RWTH-ACS/dino/sw/arduino/analog-in/README.md

# ADC LTC1864 - 16bit

## Components
  - [LTC2312-14 Datasheet](https://www.analog.com/media/en/technical-documentation/data-sheets/231214fa.pdf)

## Code

In ```ltc_test``` you find the code used to test the SPI communication using the following wiring setup

## Test Wiring

Wiring

**NOTE: The chip in picture is the LTC2312-14**
