RWTH-ACS/dino/hw/eagle/fpga-fmc/adapter_board.csv

Part | Value | Device | Package | Description | Added
3V3_GOOD2 |  | LEDCHIPLED_0805 | CHIPLED_0805 | LED | y
5V_GOOD |  | LEDCHIPLED_0805 | CHIPLED_0805 | LED | y
12V_GOOD |  | LEDCHIPLED_0805 | CHIPLED_0805 | LED | y
C1 | 100n | C-EUC0805 | C0805 | CAPACITOR, European symbol | y
C2 | 100n | C-EUC0805 | C0805 | CAPACITOR, European symbol | y
C3 | 100n | C-EUC0805 | C0805 | CAPACITOR, European symbol | y
C4 | 1u | C-EUC0805 | C0805 | CAPACITOR, European symbol | y
C5 | 100n | C-EUC0805 | C0805 | CAPACITOR, European symbol | y
C6 | 100n | C-EUC0805 | C0805 | CAPACITOR, European symbol | y
C7 | 100n | C-EUC0805 | C0805 | CAPACITOR, European symbol | y
C8 | 100n | C-EUC0805 | C0805 | CAPACITOR, European symbol | y
C9 | 100n | C-EUC0805 | C0805 | CAPACITOR, European symbol | y
C10 | 100n | C-EUC0805 | C0805 | CAPACITOR, European symbol | y
C11 | 100n | C-EUC0805 | C0805 | CAPACITOR, European symbol | y
C12 | 100n | C-EUC0805 | C0805 | CAPACITOR, European symbol | y
C13 | 100n | C-EUC0805 | C0805 | CAPACITOR, European symbol | y
C14 | 100n | C-EUC0805 | C0805 | CAPACITOR, European symbol | y
C15 | 100n | C-EUC0805 | C0805 | CAPACITOR, European symbol | y
C16 | 100n | C-EUC0805 | C0805 | CAPACITOR, European symbol | y
C17 | 100n | C-EUC0805 | C0805 | CAPACITOR, European symbol | y
C18 | 100n | C-EUC0805 | C0805 | CAPACITOR, European symbol | y
C19 | 100n | C-EUC0805 | C0805 | CAPACITOR, European symbol | y
C20 | 100n | C-EUC0805 | C0805 | CAPACITOR, European symbol | y
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
RJ3_SCL | TPB1,27 | TPB1,27 | B1,27 | Test pad | nb
RJ3_SDO | TPB1,27 | TPB1,27 | B1,27 | Test pad | nb
U18 | TXS0102 | TXS0102 | VSSOP-8 |  | y
U19 | TXS0102 | TXS0102 | VSSOP-8 |  | y
U20 | TXS0102 | TXS0102 | VSSOP-8 |  | y
U21 | TXS0102 | TXS0102 | VSSOP-8 |  | y
U1 | ADM3066E | ADM3066E | MSOP-10 |  | y
U2 | ADM3066E | ADM3066E | MSOP-10 |  | y
U3 | ADM3066E | ADM3066E | MSOP-10 |  | y
U4 | ADM3066E | ADM3066E | MSOP-10 |  | y
U5 | ADM3066E | ADM3066E | MSOP-10 |  | y
U6 | ADM3066E | ADM3066E | MSOP-10 |  | y
U7 | ADM3066E | ADM3066E | MSOP-10 |  | y
U8 | ADM3066E | ADM3066E | MSOP-10 |  | y
U9 | ADM3066E | ADM3066E | MSOP-10 |  | y
U10 | ADM3066E | ADM3066E | MSOP-10 |  | y
U11 | ADM3066E | ADM3066E | MSOP-10 |  | y
U12 | ADM3066E | ADM3066E | MSOP-10 |  | y
U13 | ADM3066E | ADM3066E | MSOP-10 |  | y
U14 | ADM3066E | ADM3066E | MSOP-10 |  | y
U15 | ADM3066E | ADM3066E | MSOP-10 |  | y
U16 | ADM3066E | ADM3066E | MSOP-10 |  | y
U17 | TCA9548A | PCA9548A | PCA9548 |  | self
X1 |  | W237-02P | W237-132 | WAGO SREW CLAMP | y
