RWTH-ACS/dino/hw/eagle/analog-in/diagram.pdf

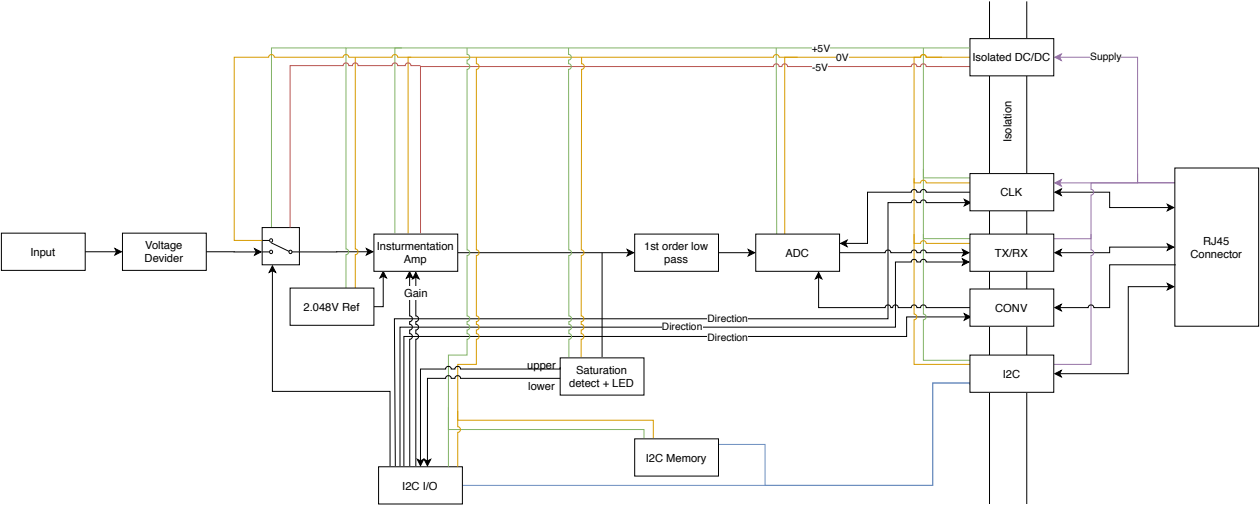
[picture p1: page 1]
Direction; Voltage; Devider Input; 1st order low; pass; ADC; CLK; Supply; RJ45 Connector; Isolated DC/DC; 2.048V Ref; I2C Memory; Isolation; CONV; Insturmentation Amp; Saturation detect + LED; upper; lower; Gain
