RWTH-ACS/dino/hw/kicad/analog-in/analog-in.kicad_pcb

## KiCad design hw/kicad/analog-in/analog-in.kicad_pcb (2024-04-16)

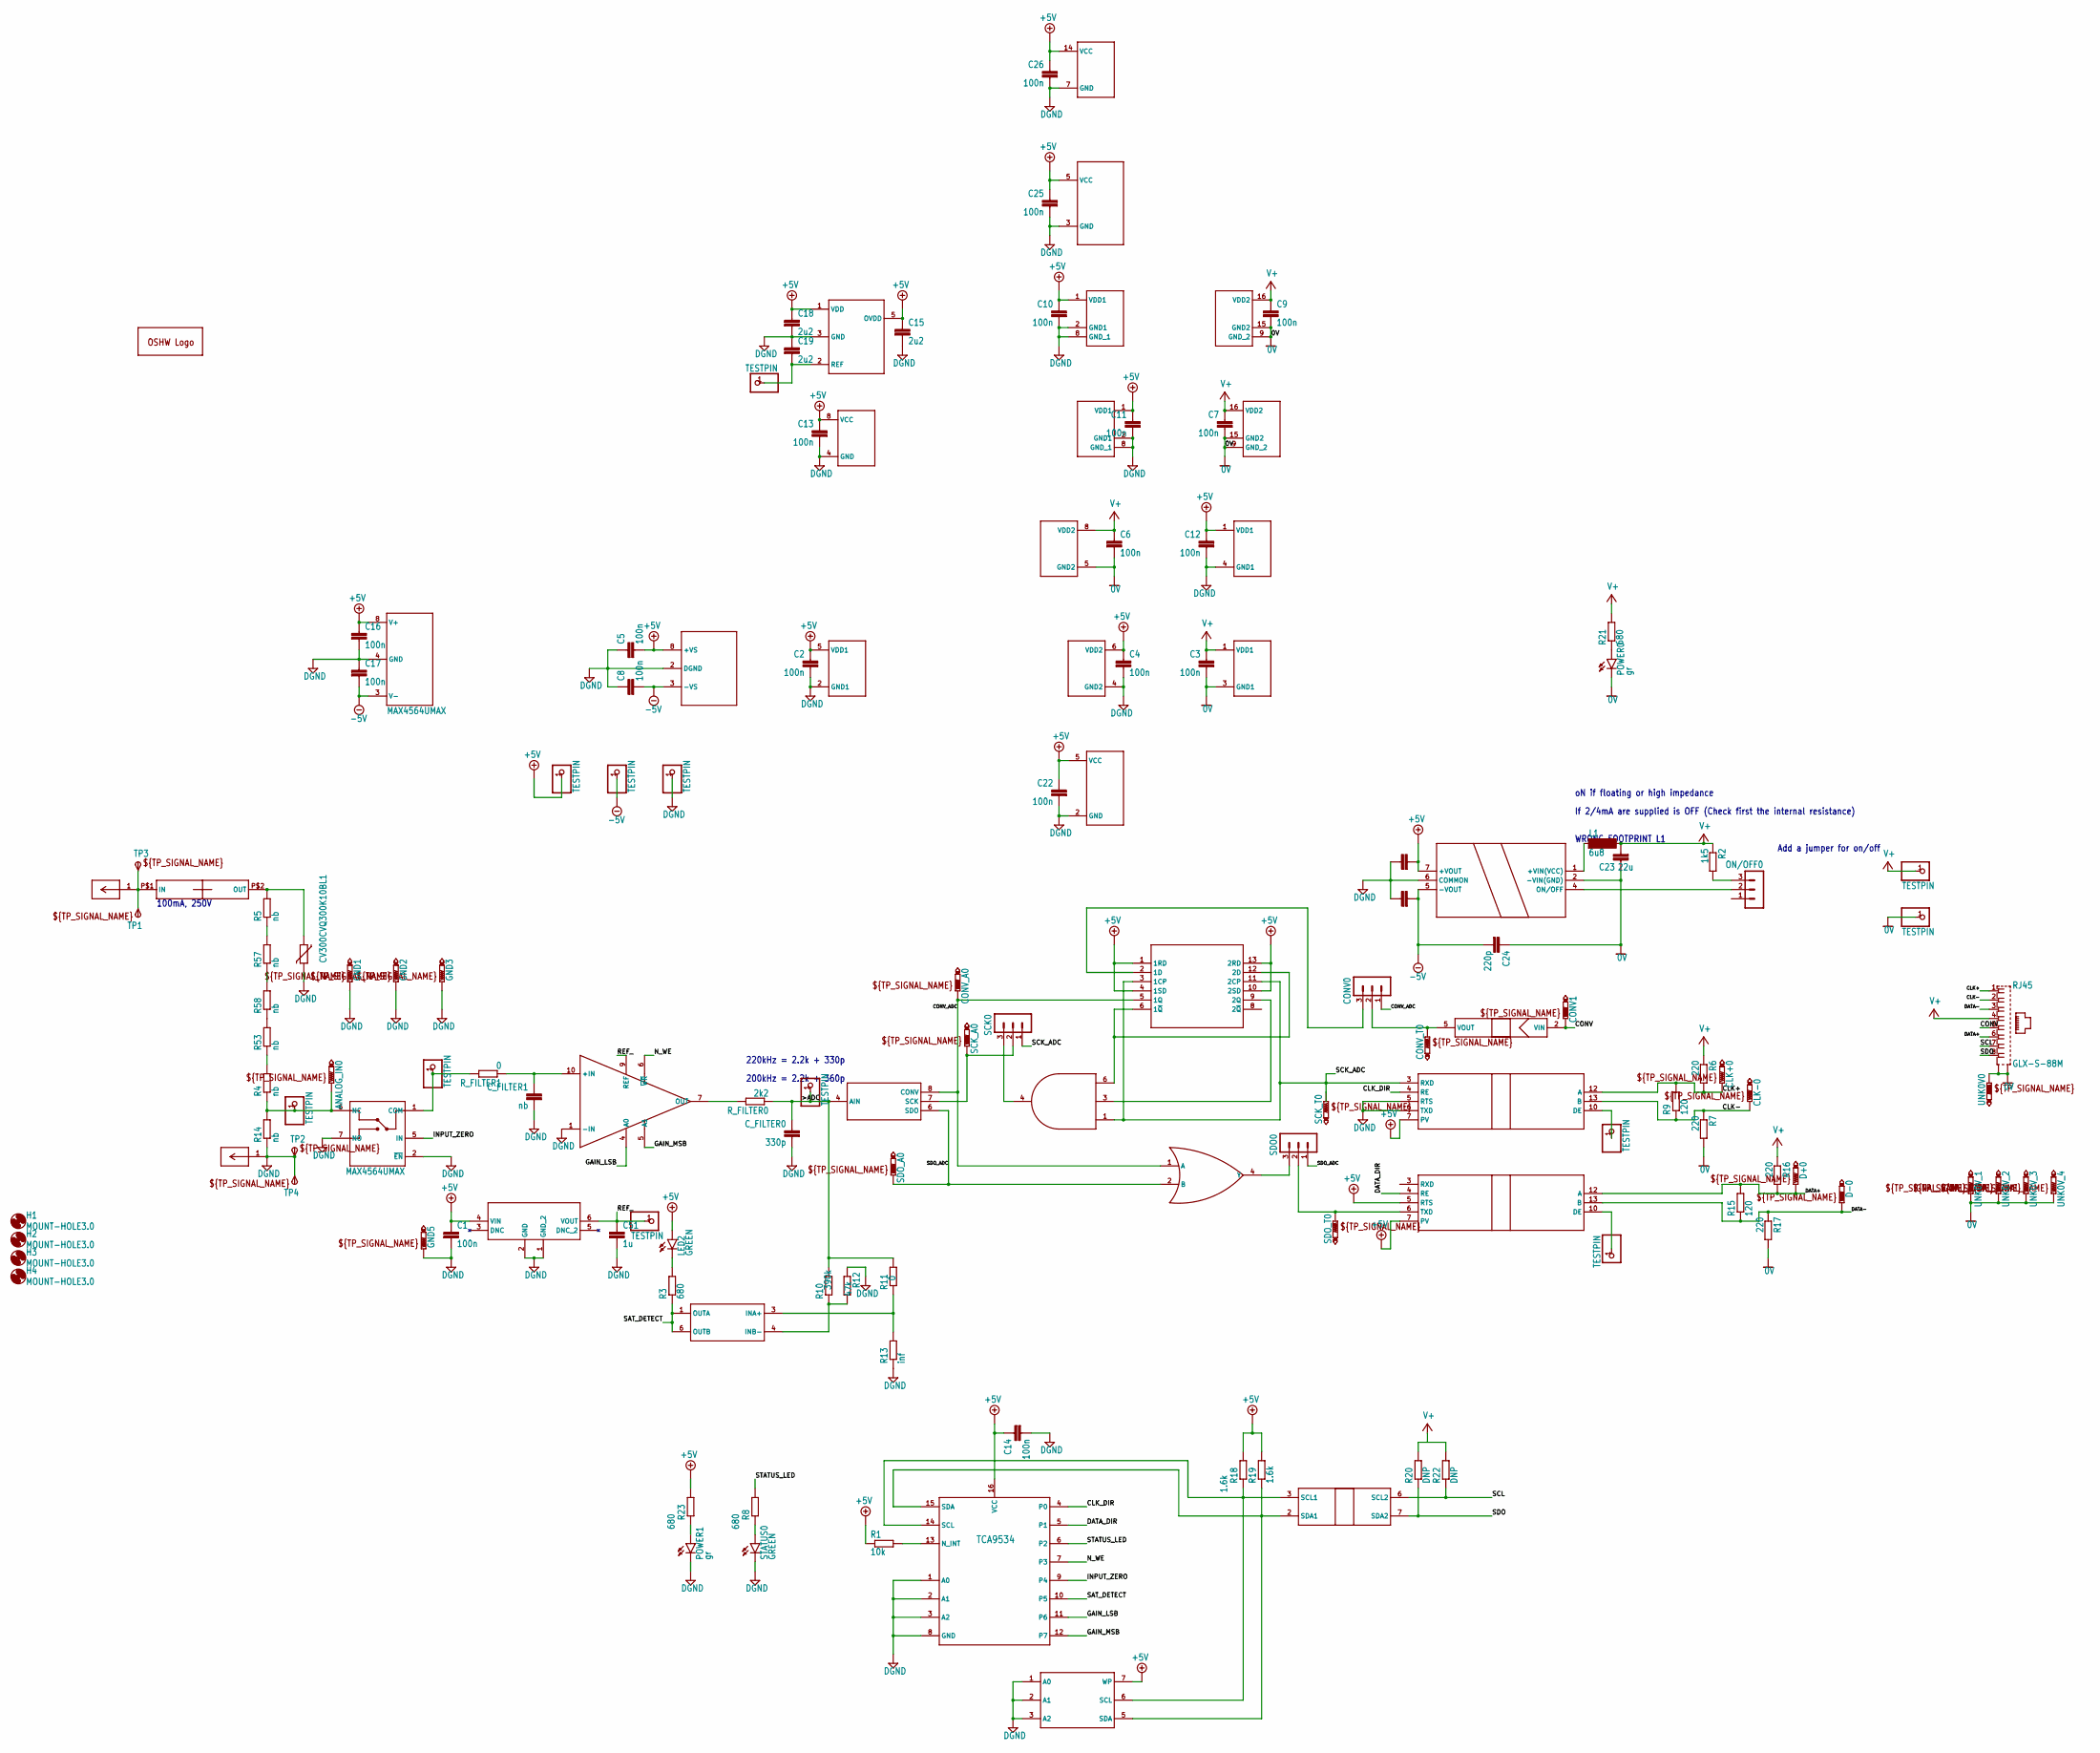
[picture p2: schematic analog-in.kicad_sch]

Parts:
+5V0: TESTPIN; 1X01
-5V0: TESTPIN; 1X01
ADC_0: LTC2314-14; TSOT-23_TS8_LIT; DIGIKEY LTC2314ITS8-14#TRMPBFT-ND
ADC_IN0: TESTPIN; 1X01
ADC_REF0: TESTPIN; 1X01
ANALOG_IN0: PTR1B1,27; B1,27
A_IN0: TESTPIN; 1X01
C1: 100n; C0805; DIGIKEY 478-7962-1-ND
C2, C3, C4, C5, C6, C7, C8, C9, C10, C11, C12, C13, C14, C16, C17, C20, C21, C22, C25, C26: 100n; C0805K; DIGIKEY 478-7962-1-ND
C15, C18, C19: 2u2; C0805K; DIGIKEY 1276-2954-2-ND
C23: 22u; C1206; DIGIKEY 399-17625-1-ND
C24: 220p; C1808; DIGIKEY 478-10448-2-ND
C51: 1u; C0805; DIGIKEY 1276-6471-1-ND
CLK+0: PTR1B1,27; B1,27
CLK-0: PTR1B1,27; B1,27
CONV0: MA03-1; DIGIKEY 732-5316-ND
CONV1: PTR1B1,27; B1,27
CONVERSION0: ADUM4120-1ARIZ; RI_6_1_ADI; DIGIKEY ADUM4120-1ARIZ-ND
CONV_A0: PTR1B1,27; B1,27
CONV_T0: PTR1B1,27; B1,27
C_FILTER0: 330p; C0805K; DIGIKEY 478-9885-1-ND
C_FILTER1: nb; C0805K; DIGIKEY 478-08055C121KAT2ACT-ND
D+0: PTR1B1,27; B1,27
D-0: PTR1B1,27; B1,27
DC-DC_CONVERTER0: TDN_3-1211WI; TDN3_TRP; MANUFACTURER_PART_NUMBER TDN 3-1221WISM; DIGIKEY TDN3-1221WISM-ND
DE_CLK0: TESTPIN; 1X01
DE_DATA0: TESTPIN; 1X01
DGND0: TESTPIN; 1X01
FILTER0: TESTPIN; 1X01
FLIP-FLOP0: 74HC74PW-Q100,118; TSSOP14_SOT402-1_NEX; DIGIKEY 1727-4083-1-ND
GND1, GND2, GND3, GND5: PTR1B1,27; B1,27
GND_4: TESTPIN; 1X01
GOLD_ORB_SM1: OSHWLOGOLOGO8MM; OSHW_8MM
H1, H2, H3, H4: MOUNT-HOLE3.0; 3,0
I2C0: ADUM1251WARZ; R_8_ADI; DIGIKEY ADUM1251ARZ-RL7TR-ND
INSTR_AMP0: AD8250ARMZ; RM_10_ADI; DIGIKEY AD8250ARMZ-R7TR-ND
L1: 6u8; SM-NE29; DIGIKEY 1951-1045-ND
LED2: GREEN; SML0805; DIGIKEY LTST-C170GKT
MINUS0: 23.3200-21; CONN_23.3200-21_SBI; DIGIKEY 501-73099-0-ND
MOV1: CV300CVQ300K10BL1; CVQ300K10
ON/OFF0: MA03-1; DIGIKEY 732-5316-ND
PLUS0: 23.3200-21; CONN_23.3200-21_SBI; DIGIKEY 501-73099-2-ND
POWER0, POWER1: gr; SML0805; DIGIKEY LTST-C170GKT
R1: 10k; R0805; DIGIKEY P10KDATR-ND
R2: 1k5; R0805; DIGIKEY P1.5KDATR-ND
R3, R21: 680; R0805; DIGIKEY A129747TR-ND
R4, R5, R53, R57, R58: nb; R1206; MOUSER check config
R6, R7, R16, R17: 220; R0805; DIGIKEY Y1624195R000Q9R-ND
R8, R23: 680; R0805
R9, R15: 120; R0805; DIGIKEY Y1629-120DTR-ND
R10: 390k; R0805; DIGIKEY 2019-RK73H2ATTD3903FTR-ND
R11: 0; R0805; DIGIKEY RMCF0805ZT0R00TR-ND
R12: 47k; R0805; DIGIKEY A130144TR-ND
R13: inf; R0805
R14: nb; R0805; MOUSER check config
R18, R19: 1.6k; R0805
R20, R22: DNP; R0805
REF0: LT6654AIS6-2.048TRMPBF; S_6_ADI; DIGIKEY 161-LT6654BHS6-2.048#WTRPBFTR-ND
REF_2.048: TESTPIN; 1X01
RJ45: GLX-S-88M; DIGIKEY 2092-GLX-S-88M-ND
ROHM_I2C0: BR24T1MF-3AM; BR24T1MFJ-3AM; DIGIKEY BR24T1MF-3AME2TR-ND
R_FILTER0: 2k2; R0805; DIGIKEY A106060TR-ND
R_FILTER1: 0; R0805; DIGIKEY P220DACT-ND
SATURATION_DETECT0: ADCMP670-1YUJZ-RL7; UJ_6_ADI; DIGIKEY ADCMP670-1YUJZ-RL7TR-ND
SCK0: MA03-1; DIGIKEY 732-5316-ND
SCK_A0: PTR1B1,27; B1,27
SCK_T0: PTR1B1,27; B1,27
SDO0: MA03-1; DIGIKEY 732-5316-ND
SDO_A0: PTR1B1,27; B1,27
SDO_T0: PTR1B1,27; B1,27
SERIAL_CLOCK0: ADM2486BRWZ-REEL; RW_16_ADI; DIGIKEY ADM2486BRWZ-REELTR-ND
SERIAL_DATA0: ADM2486BRWZ-REEL; RW_16_ADI; DIGIKEY ADM2486BRWZ-REELTR-ND
SN74LVC1G32: SN74LVC1G32DCKTDCK5-M; DCK5-M
STATUS0: GREEN; CHIPLED_0805; DIGIKEY LTST-C170GKT
TP1, TP2, TP3, TP4: TPSTP20SQ; TP20SQ
U$1: 0508.500MXEP; DIGIKEY 283-4458-1-ND
U$2: TCA9534; TSSOP16L
U$20: MAX4564UMAX; UMAX8; DIGIKEY MAX4564EUA+TR-ND
UNK0V0, UNK0V_1, UNK0V_2, UNK0V_3, UNK0V_4: PTR1B1,27; B1,27
UNK74LVC1G11: SN74LVC1G11DBVRDBV0006A_L; DBV0006A_L
VCC0: TESTPIN; 1X01

Connections:
0V: C3.2, C6.2, C7.2, C9.2, C23.1, C24.1, CONVERSION0.3 (GND1), DC-DC_CONVERTER0.2 (-VIN(GND)), DGND0.1, I2C0.5 (GND2), POWER0.C, R7.2, R17.2, RJ45.S1, RJ45.S2, SERIAL_CLOCK0.9 (GND_2), SERIAL_CLOCK0.15 (GND2), SERIAL_DATA0.9 (GND_2), SERIAL_DATA0.15 (GND2), UNK0V0.TP, UNK0V_1.TP, UNK0V_2.TP, UNK0V_3.TP, UNK0V_4.TP
+5V: +5V0.1, ADC_0.1 (VDD), ADC_0.5 (OVDD), C1.1, C2.1, C4.1, C5.2, C10.1, C11.1, C12.1, C13.1, C14.1, C15.1, C16.1, C18.1, C20.2, C22.1, C25.1, C26.1, CONVERSION0.6 (VDD2), DC-DC_CONVERTER0.7 (+VOUT), FLIP-FLOP0.1 (1RD), FLIP-FLOP0.4 (1SD), FLIP-FLOP0.10 (2SD), FLIP-FLOP0.13 (2RD), FLIP-FLOP0.14 (VCC), I2C0.1 (VDD1), INSTR_AMP0.8 (+VS), LED2.A, R1.1, R18.2, R19.2, R23.2, REF0.4 (VIN), ROHM_I2C0.7 (WP), ROHM_I2C0.8 (VCC), SATURATION_DETECT0.5 (VDD1), SERIAL_CLOCK0.1 (VDD1), SERIAL_CLOCK0.7 (PV), SERIAL_DATA0.1 (VDD1), SERIAL_DATA0.5 (RTS), SERIAL_DATA0.7 (PV), SN74LVC1G32.5 (VCC), U$2.16 (VCC), U$20.8 (V+), UNK74LVC1G11.5 (VCC)
-5V: -5V0.1, C8.2, C17.2, C21.2, C24.2, DC-DC_CONVERTER0.5 (-VOUT), INSTR_AMP0.3 (-VS), U$20.3 (V-)
>ADC: ADC_0.4 (AIN), ADC_IN0.1, C_FILTER0.1, R10.2, R11.2, R_FILTER0.1
CLK+: CLK+0.TP, R6.2, R9.2, RJ45.1, SERIAL_CLOCK0.12 (A)
CLK-: CLK-0.TP, R7.1, R9.1, RJ45.2, SERIAL_CLOCK0.13 (B)
CLK_DIR: SERIAL_CLOCK0.4 (RE), U$2.4 (P0)
CONV: CONV1.TP, CONVERSION0.2 (VIN), RJ45.5
CONV_ADC: ADC_0.8 (CONV), CONV0.1, CONV_A0.TP, FLIP-FLOP0.5 (1Q), SN74LVC1G32.1 (A)
DATA+: D+0.TP, R15.2, R16.2, RJ45.6, SERIAL_DATA0.12 (A)
DATA-: D-0.TP, R15.1, R17.1, RJ45.3, SERIAL_DATA0.13 (B)
DATA_DIR: SERIAL_DATA0.4 (RE), U$2.5 (P1)
DGND: ADC_0.3 (GND), C1.2, C2.2, C4.2, C5.1, C8.1, C10.2, C11.2, C12.2, C13.2, C14.2, C15.2, C16.2, C17.1, C18.2, C19.1, C20.1, C21.1, C22.2, C25.2, C26.2, C51.2, CONVERSION0.4 (GND2), C_FILTER0.2, C_FILTER1.2, DC-DC_CONVERTER0.6 (COMMON), FLIP-FLOP0.7 (GND), GND1.TP, GND2.TP, GND3.TP, GND5.TP, GND_4.1, I2C0.4 (GND1), INSTR_AMP0.1 (-IN), INSTR_AMP0.2 (DGND), MINUS0.1, MOV1.2, POWER1.C, R12.1, R13.1, R14.1, REF0.1 (GND_2), REF0.2 (GND), ROHM_I2C0.1 (A0), ROHM_I2C0.2 (A1), ROHM_I2C0.3 (A2), ROHM_I2C0.4 (GND), SATURATION_DETECT0.2 (GND1), SERIAL_CLOCK0.2 (GND1), SERIAL_CLOCK0.5 (RTS), SERIAL_CLOCK0.6 (TXD), SERIAL_CLOCK0.8 (GND_1), SERIAL_DATA0.2 (GND1), SERIAL_DATA0.8 (GND_1), SN74LVC1G32.3 (GND), STATUS0.C, TP2.TP, TP4.TP, U$2.1 (A0), U$2.2 (A1), U$2.3 (A2), U$2.8 (GND), U$20.2 (~EN), U$20.4 (GND), U$20.7 (NO), UNK74LVC1G11.2 (GND)
GAIN_LSB: INSTR_AMP0.4 (A0), U$2.11 (P6)
GAIN_MSB: INSTR_AMP0.5 (A1), U$2.12 (P7)
INPUT_ZERO: U$2.9 (P4), U$20.5 (IN)
unnamed: INSTR_AMP0.7 (OUT), R_FILTER0.2
unnamed: R1.2, U$2.13 (N_INT)
unnamed: DE_CLK0.1, SERIAL_CLOCK0.10 (DE)
unnamed: I2C0.3 (SCL1), R18.1, ROHM_I2C0.6 (SCL), U$2.14 (SCL)
unnamed: FILTER0.1, R_FILTER1.2, U$20.1 (COM)
unnamed: I2C0.2 (SDA1), R19.1, ROHM_I2C0.5 (SDA), U$2.15 (SDA)
unnamed: DE_DATA0.1, SERIAL_DATA0.10 (DE)
unnamed: ADC_0.2 (REF), ADC_REF0.1, C19.2
unnamed: MOV1.1, R5.2, U$1.P$2 (OUT)
unnamed: DC-DC_CONVERTER0.1 (+VIN(VCC)), L1.1
unnamed: ON/OFF0.3, R2.2
unnamed: DC-DC_CONVERTER0.4 (ON/OFF), ON/OFF0.2
unnamed: SCK0.3, UNK74LVC1G11.4 (Y)
unnamed: LED2.C, R3.2
unnamed: C_FILTER1.1, INSTR_AMP0.10 (+IN), R_FILTER1.1
unnamed: PLUS0.1, TP1.TP, TP3.TP, U$1.P$1 (IN)
unnamed: R10.1, R12.2, SATURATION_DETECT0.4 (INB-)
unnamed: R11.1, R13.2, SATURATION_DETECT0.3 (INA+)
unnamed: FLIP-FLOP0.6 (1~Q), FLIP-FLOP0.12 (2D), UNK74LVC1G11.6 (C)
unnamed: ANALOG_IN0.TP, A_IN0.1, R4.1, R14.2, U$20.6 (NC)
unnamed: R57.1, R58.2
unnamed: R8.1, STATUS0.A
unnamed: FLIP-FLOP0.9 (2Q), UNK74LVC1G11.3 (B)
unnamed: CONV0.2, CONVERSION0.5 (VOUT), CONV_T0.TP
unnamed: CONV0.3, FLIP-FLOP0.2 (1D)
unnamed: ADC_0.7 (SCK), SCK0.2, SCK_A0.TP
unnamed: POWER1.A, R23.1
unnamed: R4.2, R53.1
unnamed: SDO0.2, SDO_T0.TP, SERIAL_DATA0.6 (TXD)
unnamed: SDO0.3, SN74LVC1G32.4 (Y)
unnamed: POWER0.A, R21.1
unnamed: R53.2, R58.1
unnamed: R5.1, R57.2
N_WE: INSTR_AMP0.6 (~WR), U$2.7 (P3)
REF_: C51.1, INSTR_AMP0.9 (REF), REF0.6 (VOUT), REF_2.048.1
SAT_DETECT: R3.1, SATURATION_DETECT0.1 (OUTA), SATURATION_DETECT0.6 (OUTB), U$2.10 (P5)
SCK_ADC: FLIP-FLOP0.3 (1CP), FLIP-FLOP0.11 (2CP), SCK0.1, SCK_T0.TP, SERIAL_CLOCK0.3 (RXD), UNK74LVC1G11.1 (A)
SCL: I2C0.6 (SCL2), R22.1, RJ45.7
SDO: I2C0.7 (SDA2), R20.1, RJ45.8
SDO_ADC: ADC_0.6 (SDO), SDO0.1, SDO_A0.TP, SN74LVC1G32.2 (B)
STATUS_LED: R8.2, U$2.6 (P2)
V+: C3.1, C6.1, C7.1, C9.1, C23.2, CONVERSION0.1 (VDD1), I2C0.8 (VDD2), L1.2, R2.1, R6.1, R16.1, R20.2, R21.2, R22.2, RJ45.4, SERIAL_CLOCK0.16 (VDD2), SERIAL_DATA0.16 (VDD2), VCC0.1

Notes on the sheet:
220kHz = 2.2k + 330p
WRONG FOOTPRINT L1
If 2/4mA are supplied is OFF (Check first the internal resistance)
Add a jumper for on/off
100mA, 250V
oN if floating or high impedance
200kHz = 2.2k + 360p

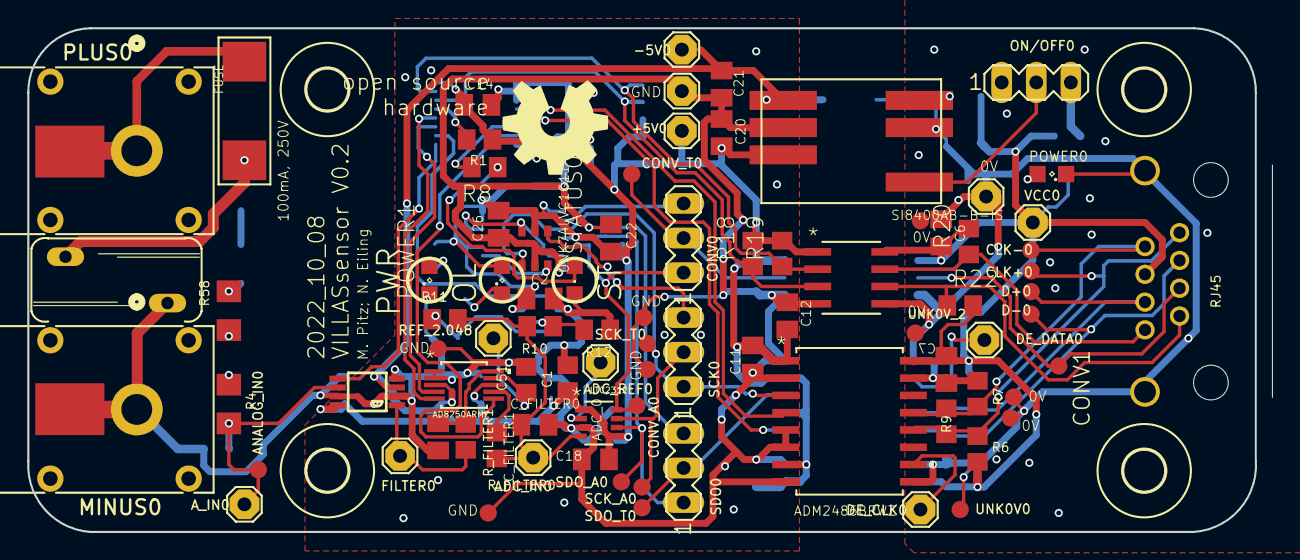
[picture p3: board analog-in.kicad_pcb from above]

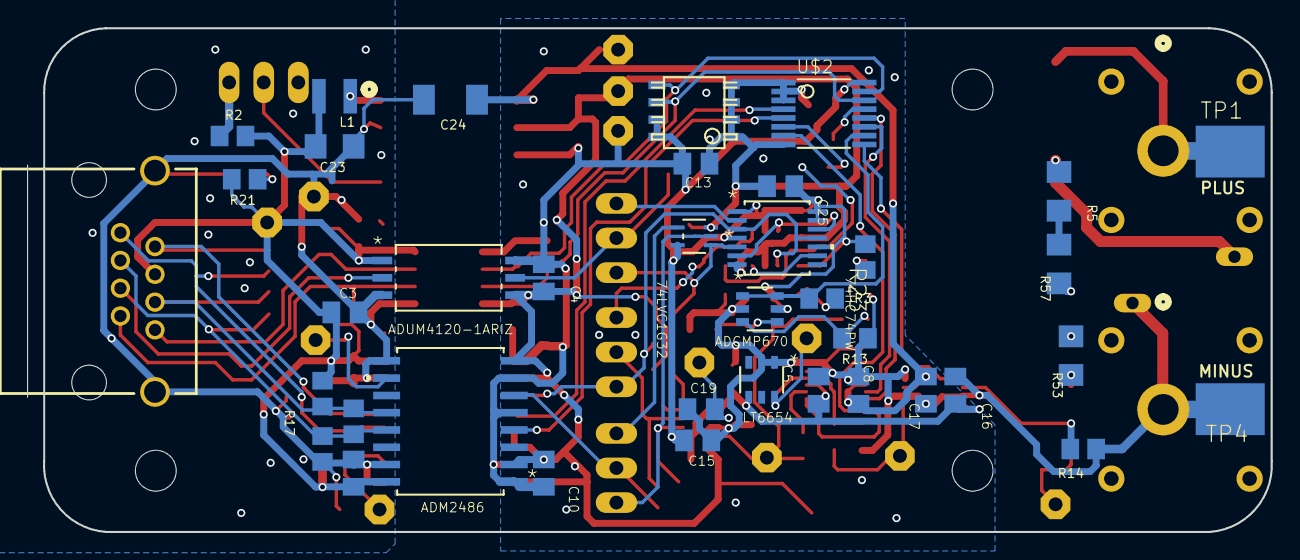
[picture p4: board analog-in.kicad_pcb from below]

Board: 2 copper layers, 91.4 x 37.0 mm, 128 parts (37 on the bottom side), 58 nets.
