RWTH-ACS/dino/hw/eagle/analog-out/analog-out.brd

## EAGLE design hw/eagle/analog-out/analog-out.brd (2023-10-16)

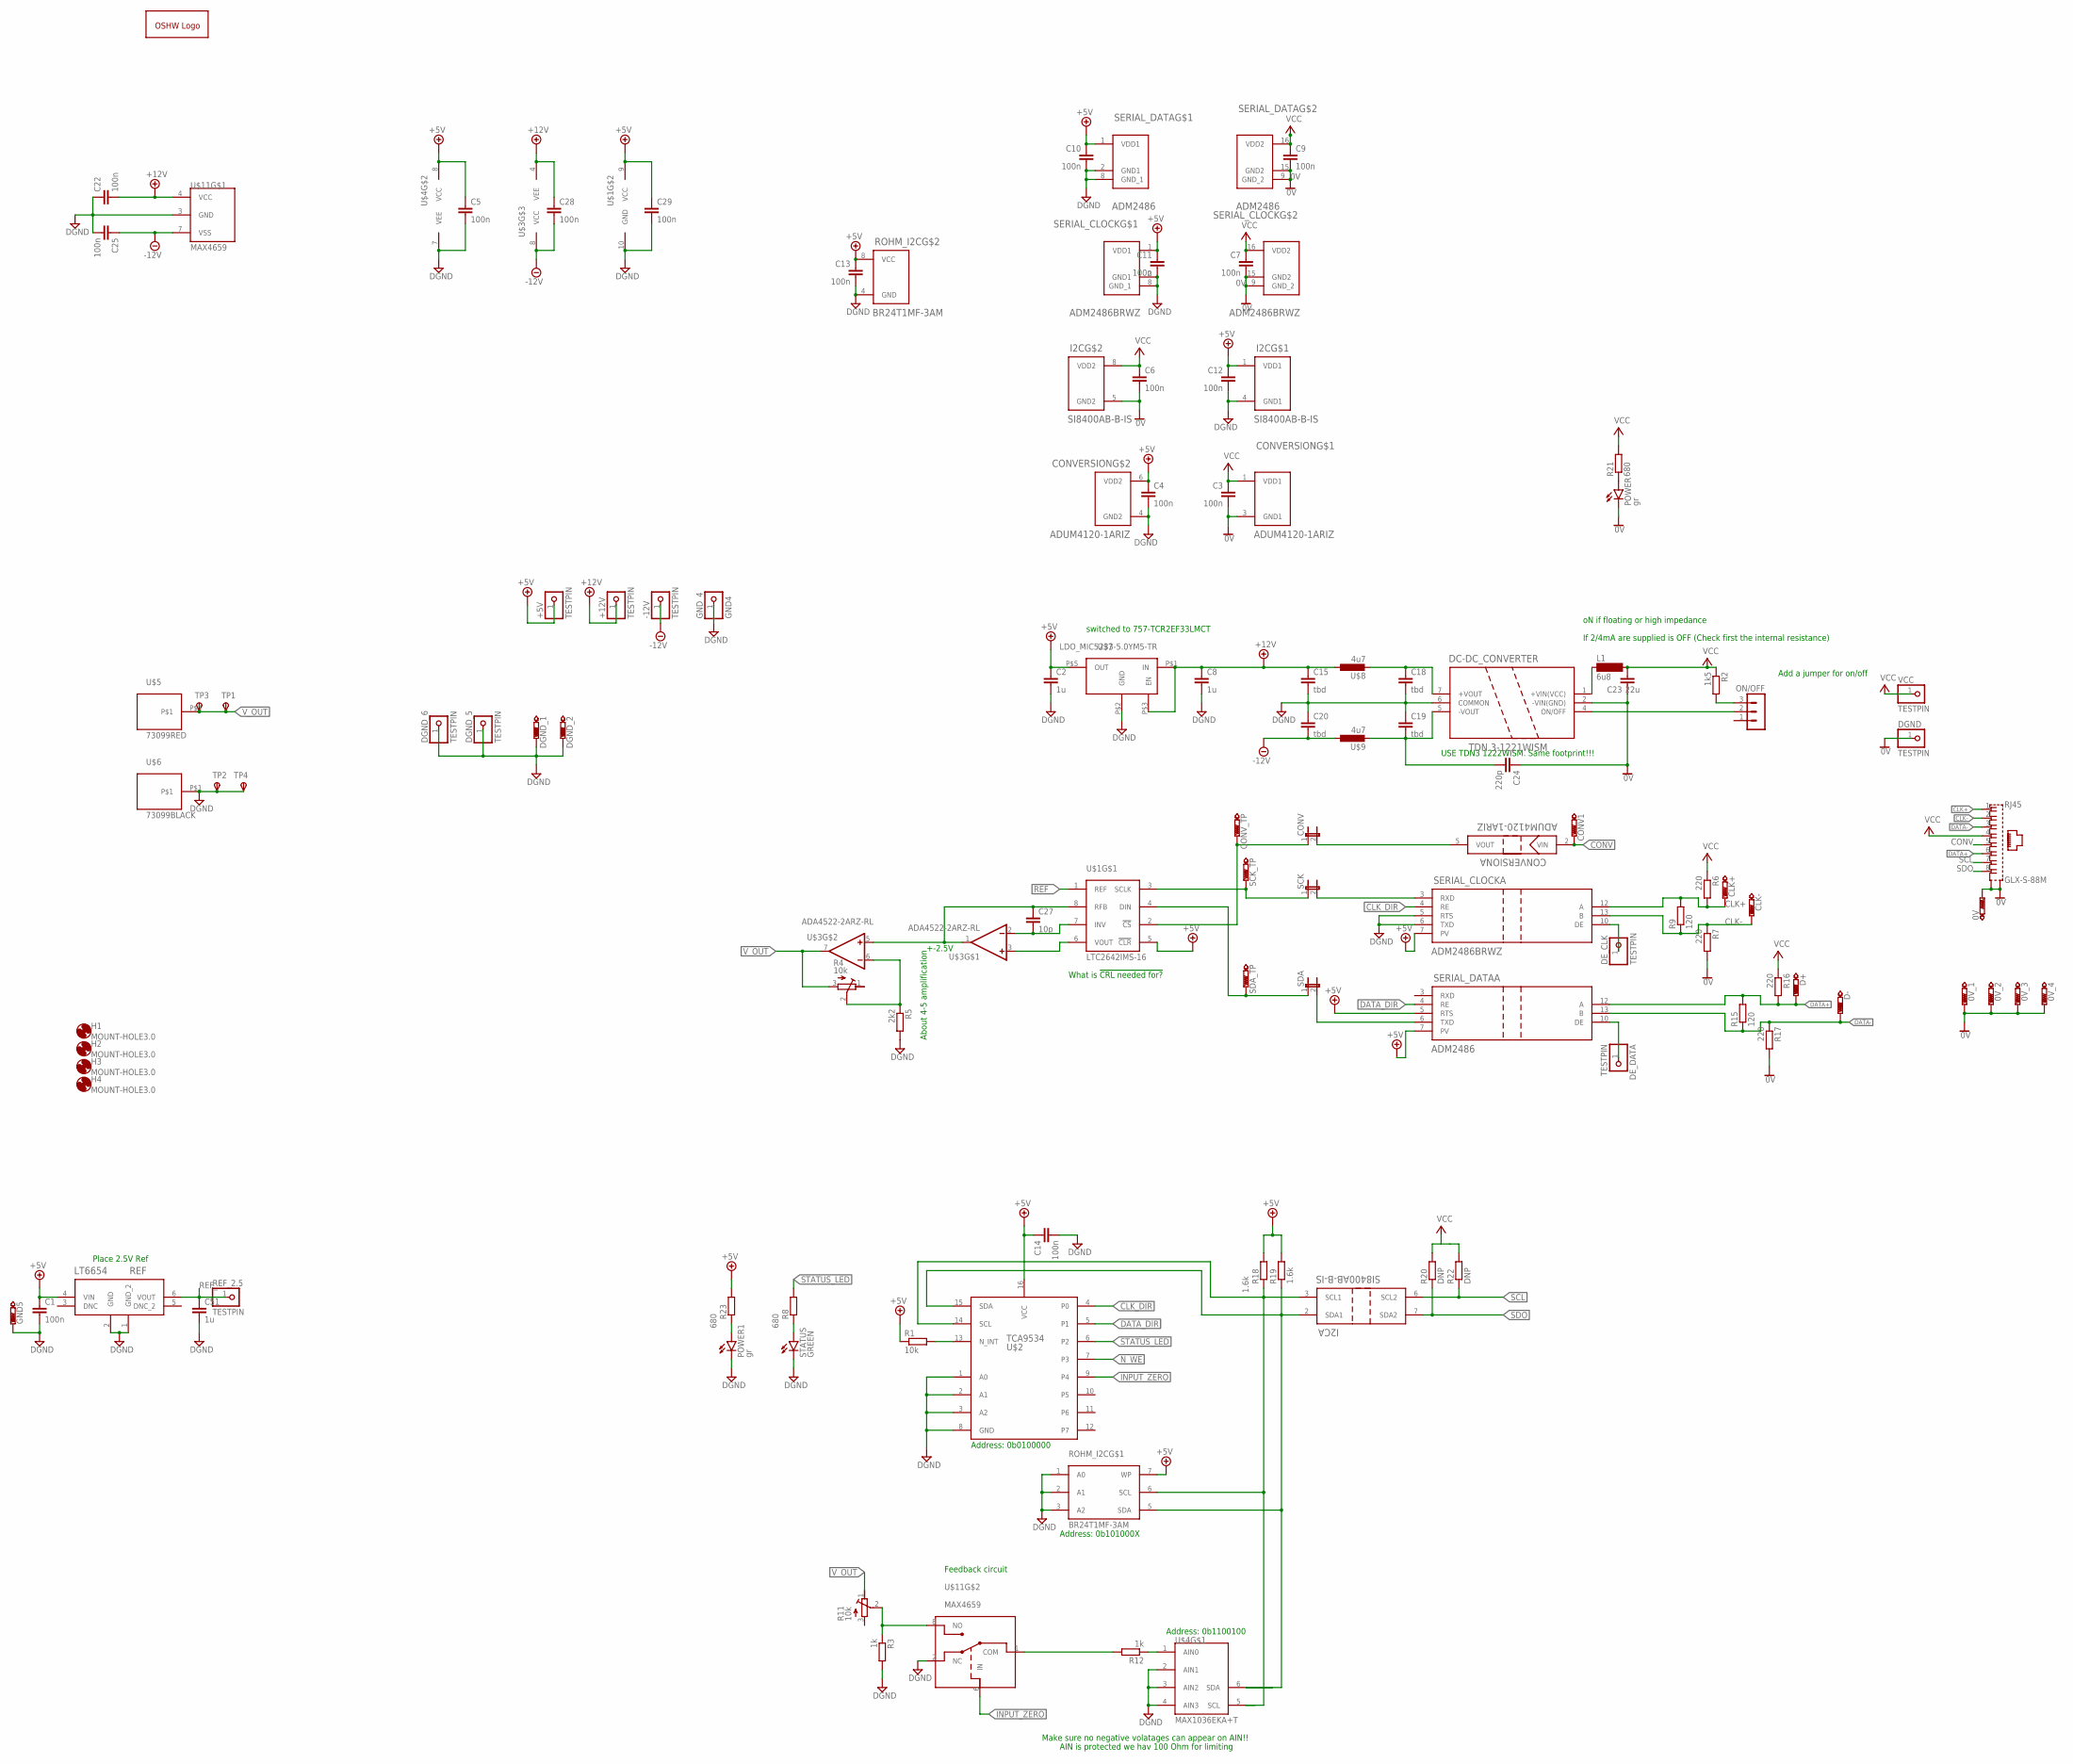
[picture p5: schematic analog-out.sch]

Parts:
0V, 0V_1, 0V_2, 0V_3, 0V_4: PTR1B1,27; B1,27
+5V, +12V: TESTPIN; 1X01
-12V: TESTPIN; 1X01
C1, C5, C22, C25, C28, C29: 100n; C0805; DIGIKEY 478-7962-1-ND
C2, C8: 1u; C0805K; DIGIKEY 478-7962-1-ND
C3, C4, C6, C7, C9, C10, C11, C12, C13, C14: 100n; C0805K; DIGIKEY 478-7962-1-ND
C15, C18, C19, C20: tbd; C0805K; DIGIKEY 478-7962-1-ND
C23: 22u; C1206; DIGIKEY 399-17625-1-ND
C24: 220p; C1808; DIGIKEY 478-10448-2-ND
C27: 10p; C0805; DIGIKEY 478-7962-1-ND
C51: 1u; C0805; DIGIKEY 1276-6471-1-ND
CLK+: PTR1B1,27; B1,27
CLK-: PTR1B1,27; B1,27
CONV: JP1E; JP1
CONV1: PTR1B1,27; B1,27
CONVERSION: ADUM4120-1ARIZ; RI_6_1_ADI; DIGIKEY ADUM4120-1ARIZ-ND
CONV_TP: PTR1B1,27; B1,27
D+: PTR1B1,27; B1,27
D-: PTR1B1,27; B1,27
DC-DC_CONVERTER: TDN 3-1221WISM; TDN3_TRP; DIGIKEY TDN3-1222WISM-ND
DE_CLK: TESTPIN; 1X01
DE_DATA: TESTPIN; 1X01
DGND: TESTPIN; 1X01
DGND_1, DGND_2: PTR1B1,27; B1,27
DGND_5, DGND_6: TESTPIN; 1X01
GND5: PTR1B1,27; B1,27
GND_4: GND4; 1X01
GOLD_ORB_SM1: OSHWLOGOLOGO8MM; OSHW_8MM
H1, H2, H3, H4: MOUNT-HOLE3.0; 3,0
I2C: SI8400AB-B-IS; R_8_ADI; MOUSER 634-SI8400AB-B-IS
L1: 6u8; SM-NE29; DIGIKEY 1951-1045-ND
ON/OFF: MA03-1; DIGIKEY 732-5316-ND
POWER, POWER1: gr; SML0805; DIGIKEY LTST-C170GKT
R1: 10k; R0805; DIGIKEY P10KDATR-ND
R2: 1k5; R0805; DIGIKEY P1.5KDATR-ND
R3: 1k; R0805; DIGIKEY Y1629-120DTR-ND
R4, R11: 10k; RTRIMT93YA
R5: 2k2; R0805; DIGIKEY Y1629-120DTR-ND
R6, R7, R16, R17: 220; R0805; DIGIKEY Y1624195R000Q9R-ND
R8, R23: 680; R0805
R9, R15: 120; R0805; DIGIKEY Y1629-120DTR-ND
R12: 1k; R0805
R18, R19: 1.6k; R0805
R20, R22: DNP; R0805
R21: 680; R0805; DIGIKEY A129747TR-ND
REF: LT6654; S_6_ADI; DIGIKEY 505-LT6654AIS6-2.5#TRMPBFTR-ND
REF_2.5: TESTPIN; 1X01
RJ45: GLX-S-88M; DIGIKEY 2092-GLX-S-88M-ND
ROHM_I2C: BR24T1MF-3AM; BR24T1MFJ-3AM; DIGIKEY BR24T1MF-3AME2TR-ND
SCK: JP1E; JP1
SCK_TP: PTR1B1,27; B1,27
SDA: JP1E; JP1
SDA_TP: PTR1B1,27; B1,27
SERIAL_CLOCK: ADM2486BRWZ; RW_16_ADI; DIGIKEY ADM2486BRWZ-REELTR-ND
SERIAL_DATA: ADM2486; RW_16_ADI; DIGIKEY ADM2486BRWZ-REELTR-ND
STATUS: GREEN; CHIPLED_0805; DIGIKEY LTST-C170GKT
TP1, TP2, TP3, TP4: TPSTP20SQ; TP20SQ
U$1: LTC2642IMS-16; MSOP10
U$2: TCA9534; TSSOP16L; DIGIKEY 296-40574-2-ND
U$3: ADA4522-2ARZ-RL; MSOP8
U$4: MAX1036EKA+T; SOT23-8L
U$5: 73099RED; 4MM_BANANA
U$6: 73099BLACK; 4MM_BANANA
U$7: LDO_MIC5233-5.0YM5-TR; SOT23-5
U$8, U$9: 4u7; L5038P
U$11: MAX4659; UMAX8; MOUSER 700-MAX4659EUA
VCC: TESTPIN; 1X01

Connections:
0V: 0V.TP, 0V_1.TP, 0V_2.TP, 0V_3.TP, 0V_4.TP, C3.2, C6.2, C7.2, C9.2, C23.1, C24.1, CONVERSION.3 (GND1), DC-DC_CONVERTER.2 (-VIN(GND)), DGND.1, I2C.5 (GND2), POWER.C, R7.2, R17.2, RJ45.S1, RJ45.S2, SERIAL_CLOCK.9 (GND_2), SERIAL_CLOCK.15 (GND2), SERIAL_DATA.9 (GND_2), SERIAL_DATA.15 (GND2)
+5V: +5V.1, C1.1, C2.1, C4.1, C5.1, C10.1, C11.1, C12.1, C13.1, C14.1, C29.1, CONVERSION.6 (VDD2), I2C.1 (VDD1), R1.1, R18.2, R19.2, R23.2, REF.4 (VIN), ROHM_I2C.7 (WP), ROHM_I2C.8 (VCC), SERIAL_CLOCK.1 (VDD1), SERIAL_CLOCK.7 (PV), SERIAL_DATA.1 (VDD1), SERIAL_DATA.5 (RTS), SERIAL_DATA.7 (PV), U$1.5 (!CLR), U$1.9 (VCC), U$2.16 (VCC), U$4.8 (VCC), U$7.P$5 (OUT)
+12V: +12V.1, C8.1, C15.1, C22.2, C28.1, U$3.4 (VEE), U$7.P$1 (IN), U$7.P$3 (EN), U$8.1, U$11.4 (VCC)
-12V: -12V.1, C20.2, C25.1, C28.2, U$3.8 (VCC), U$9.1, U$11.7 (VSS)
CLK+: CLK+.TP, R6.2, R9.2, RJ45.1, SERIAL_CLOCK.12 (A)
CLK-: CLK-.TP, R7.1, R9.1, RJ45.2, SERIAL_CLOCK.13 (B)
CLK_DIR: SERIAL_CLOCK.4 (RE), U$2.4 (P0)
CONV: CONV1.TP, CONVERSION.2 (VIN), RJ45.5
CONV_ADC: CONV.1, CONV_TP.TP, U$1.2 (!CS)
DATA+: D+.TP, R15.2, R16.2, RJ45.6, SERIAL_DATA.12 (A)
DATA-: D-.TP, R15.1, R17.1, RJ45.3, SERIAL_DATA.13 (B)
DATA_DIR: SERIAL_DATA.4 (RE), U$2.5 (P1)
DGND: C1.2, C2.2, C4.2, C5.2, C8.2, C10.2, C11.2, C12.2, C13.2, C14.2, C15.2, C18.2, C19.1, C20.1, C22.1, C25.2, C29.2, C51.2, CONVERSION.4 (GND2), DC-DC_CONVERTER.6 (COMMON), DGND_1.TP, DGND_2.TP, DGND_5.1, DGND_6.1, GND5.TP, GND_4.1, I2C.4 (GND1), POWER1.C, R3.2, R5.2, REF.1 (GND_2), REF.2 (GND), ROHM_I2C.1 (A0), ROHM_I2C.2 (A1), ROHM_I2C.3 (A2), ROHM_I2C.4 (GND), SERIAL_CLOCK.2 (GND1), SERIAL_CLOCK.5 (RTS), SERIAL_CLOCK.6 (TXD), SERIAL_CLOCK.8 (GND_1), SERIAL_DATA.2 (GND1), SERIAL_DATA.8 (GND_1), STATUS.C, TP2.TP, TP4.TP, U$1.10 (GND), U$2.1 (A0), U$2.2 (A1), U$2.3 (A2), U$2.8 (GND), U$4.2 (AIN1), U$4.3 (AIN2), U$4.4 (AIN3), U$4.7 (VEE), U$6.P$1, U$7.P$2 (GND), U$11.2 (NC), U$11.3 (GND)
INPUT_ZERO: U$2.9 (P4), U$11.6 (IN)
unnamed: C27.2, U$1.7 (INV), U$3.2 (-IN)
unnamed: R1.2, U$2.13 (N_INT)
unnamed: DE_CLK.1, SERIAL_CLOCK.10 (DE)
unnamed: SDA.2, SERIAL_DATA.6 (TXD)
unnamed: U$1.6 (VOUT), U$3.3 (+IN)
unnamed: C19.2, C24.2, DC-DC_CONVERTER.5 (-VOUT), U$9.2
unnamed: DE_DATA.1, SERIAL_DATA.10 (DE)
unnamed: C27.1, U$1.8 (RFB), U$3.1 (OUT), U$3.5 (+IN)
unnamed: DC-DC_CONVERTER.1 (+VIN(VCC)), L1.1
unnamed: ON/OFF.3, R2.2
unnamed: DC-DC_CONVERTER.4 (ON/OFF), ON/OFF.2
unnamed: R12.1, U$4.1 (AIN0)
unnamed: I2C.2 (SDA1), R19.1, ROHM_I2C.5 (SDA), U$2.15 (SDA), U$4.6 (SDA)
unnamed: R4.2 (S), R5.1, U$3.6 (-IN)
unnamed: R3.1, R11.2 (S), U$11.8 (NO)
unnamed: I2C.3 (SCL1), R18.1, ROHM_I2C.6 (SCL), U$2.14 (SCL), U$4.5 (SCL)
unnamed: R12.2, U$11.1 (COM)
unnamed: C18.1, DC-DC_CONVERTER.7 (+VOUT), U$8.2
unnamed: R8.1, STATUS.A
unnamed: CONV.2, CONVERSION.5 (VOUT)
unnamed: SCK.1, SCK_TP.TP, U$1.3 (SCLK)
unnamed: POWER1.A, R23.1
unnamed: POWER.A, R21.1
N_WE: U$2.7 (P3)
REF_: C51.1, REF.6 (VOUT), REF_2.5.1, U$1.1 (REF)
SCK_ADC: SCK.2, SERIAL_CLOCK.3 (RXD)
SCL: I2C.6 (SCL2), R22.1, RJ45.7
SDO: I2C.7 (SDA2), R20.1, RJ45.8
SDO_ADC: SDA.1, SDA_TP.TP, U$1.4 (DIN)
STATUS_LED: R8.2, U$2.6 (P2)
V+: C3.1, C6.1, C7.1, C9.1, C23.2, CONVERSION.1 (VDD1), I2C.8 (VDD2), L1.2, R2.1, R6.1, R16.1, R20.2, R21.2, R22.2, RJ45.4, SERIAL_CLOCK.16 (VDD2), SERIAL_DATA.16 (VDD2), VCC.1
V_OUT: R4.3 (A), R11.1 (E), TP1.TP, TP3.TP, U$3.7 (OUT), U$5.P$1

Notes on the sheet:
oN if floating or high impedance
If 2/4mA are supplied is OFF (Check first the internal resistance)
Add a jumper for on/off
What is !CRL needed for?
Make sure no negative volatages can appear on AIN!!
Feedback circuit
Address: 0b1100100
Address: 0b101000X
Address: 0b0100000
USE TDN3 1222WISM. Same footprint!!!
About 4-5 amplification
AIN is protected we hav 100 Ohm for limiting
+-2.5V
switched to 757-TCR2EF33LMCT
Place 2.5V Ref

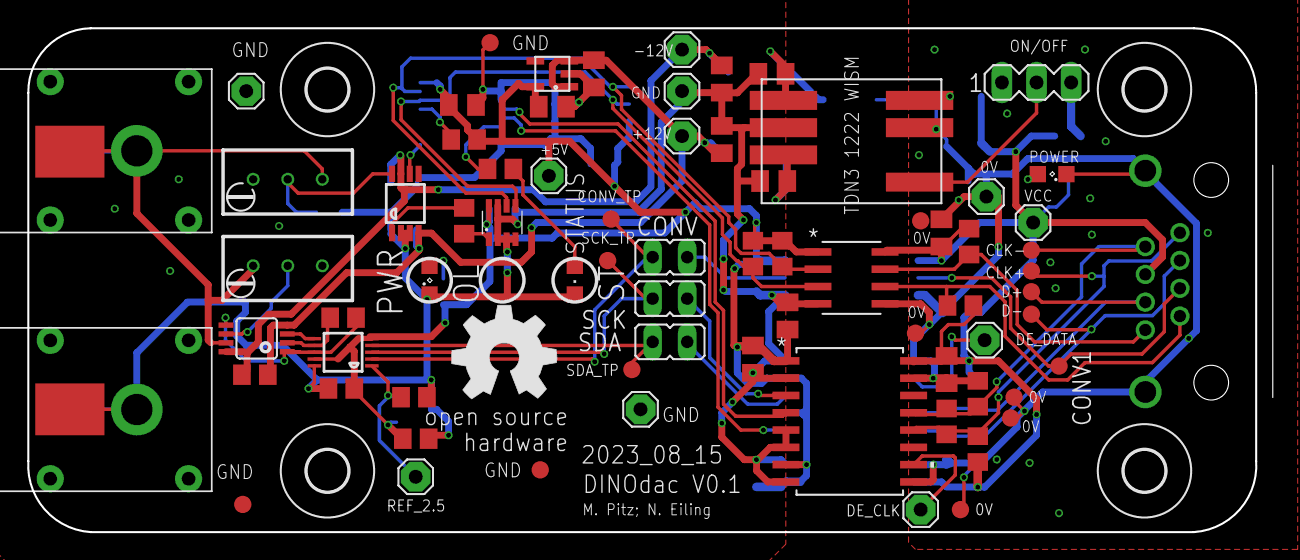
[picture p6: board analog-out.brd from above]

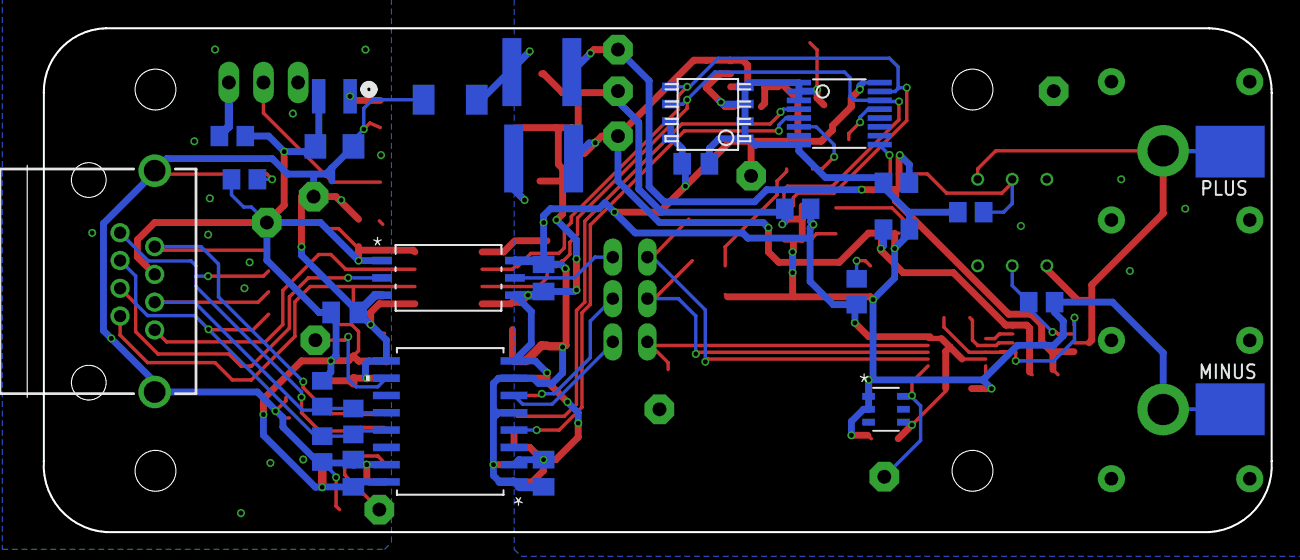
[picture p7: board analog-out.brd from below]

Board: 2 copper layers, 91.4 x 37.0 mm, 108 parts (28 on the bottom side), 45 nets.
