RWTH-ACS/dino/hw/eagle/fpga-fmc/adapter_board.brd

## EAGLE design hw/eagle/fpga-fmc/adapter_board.brd (2022-09-19)

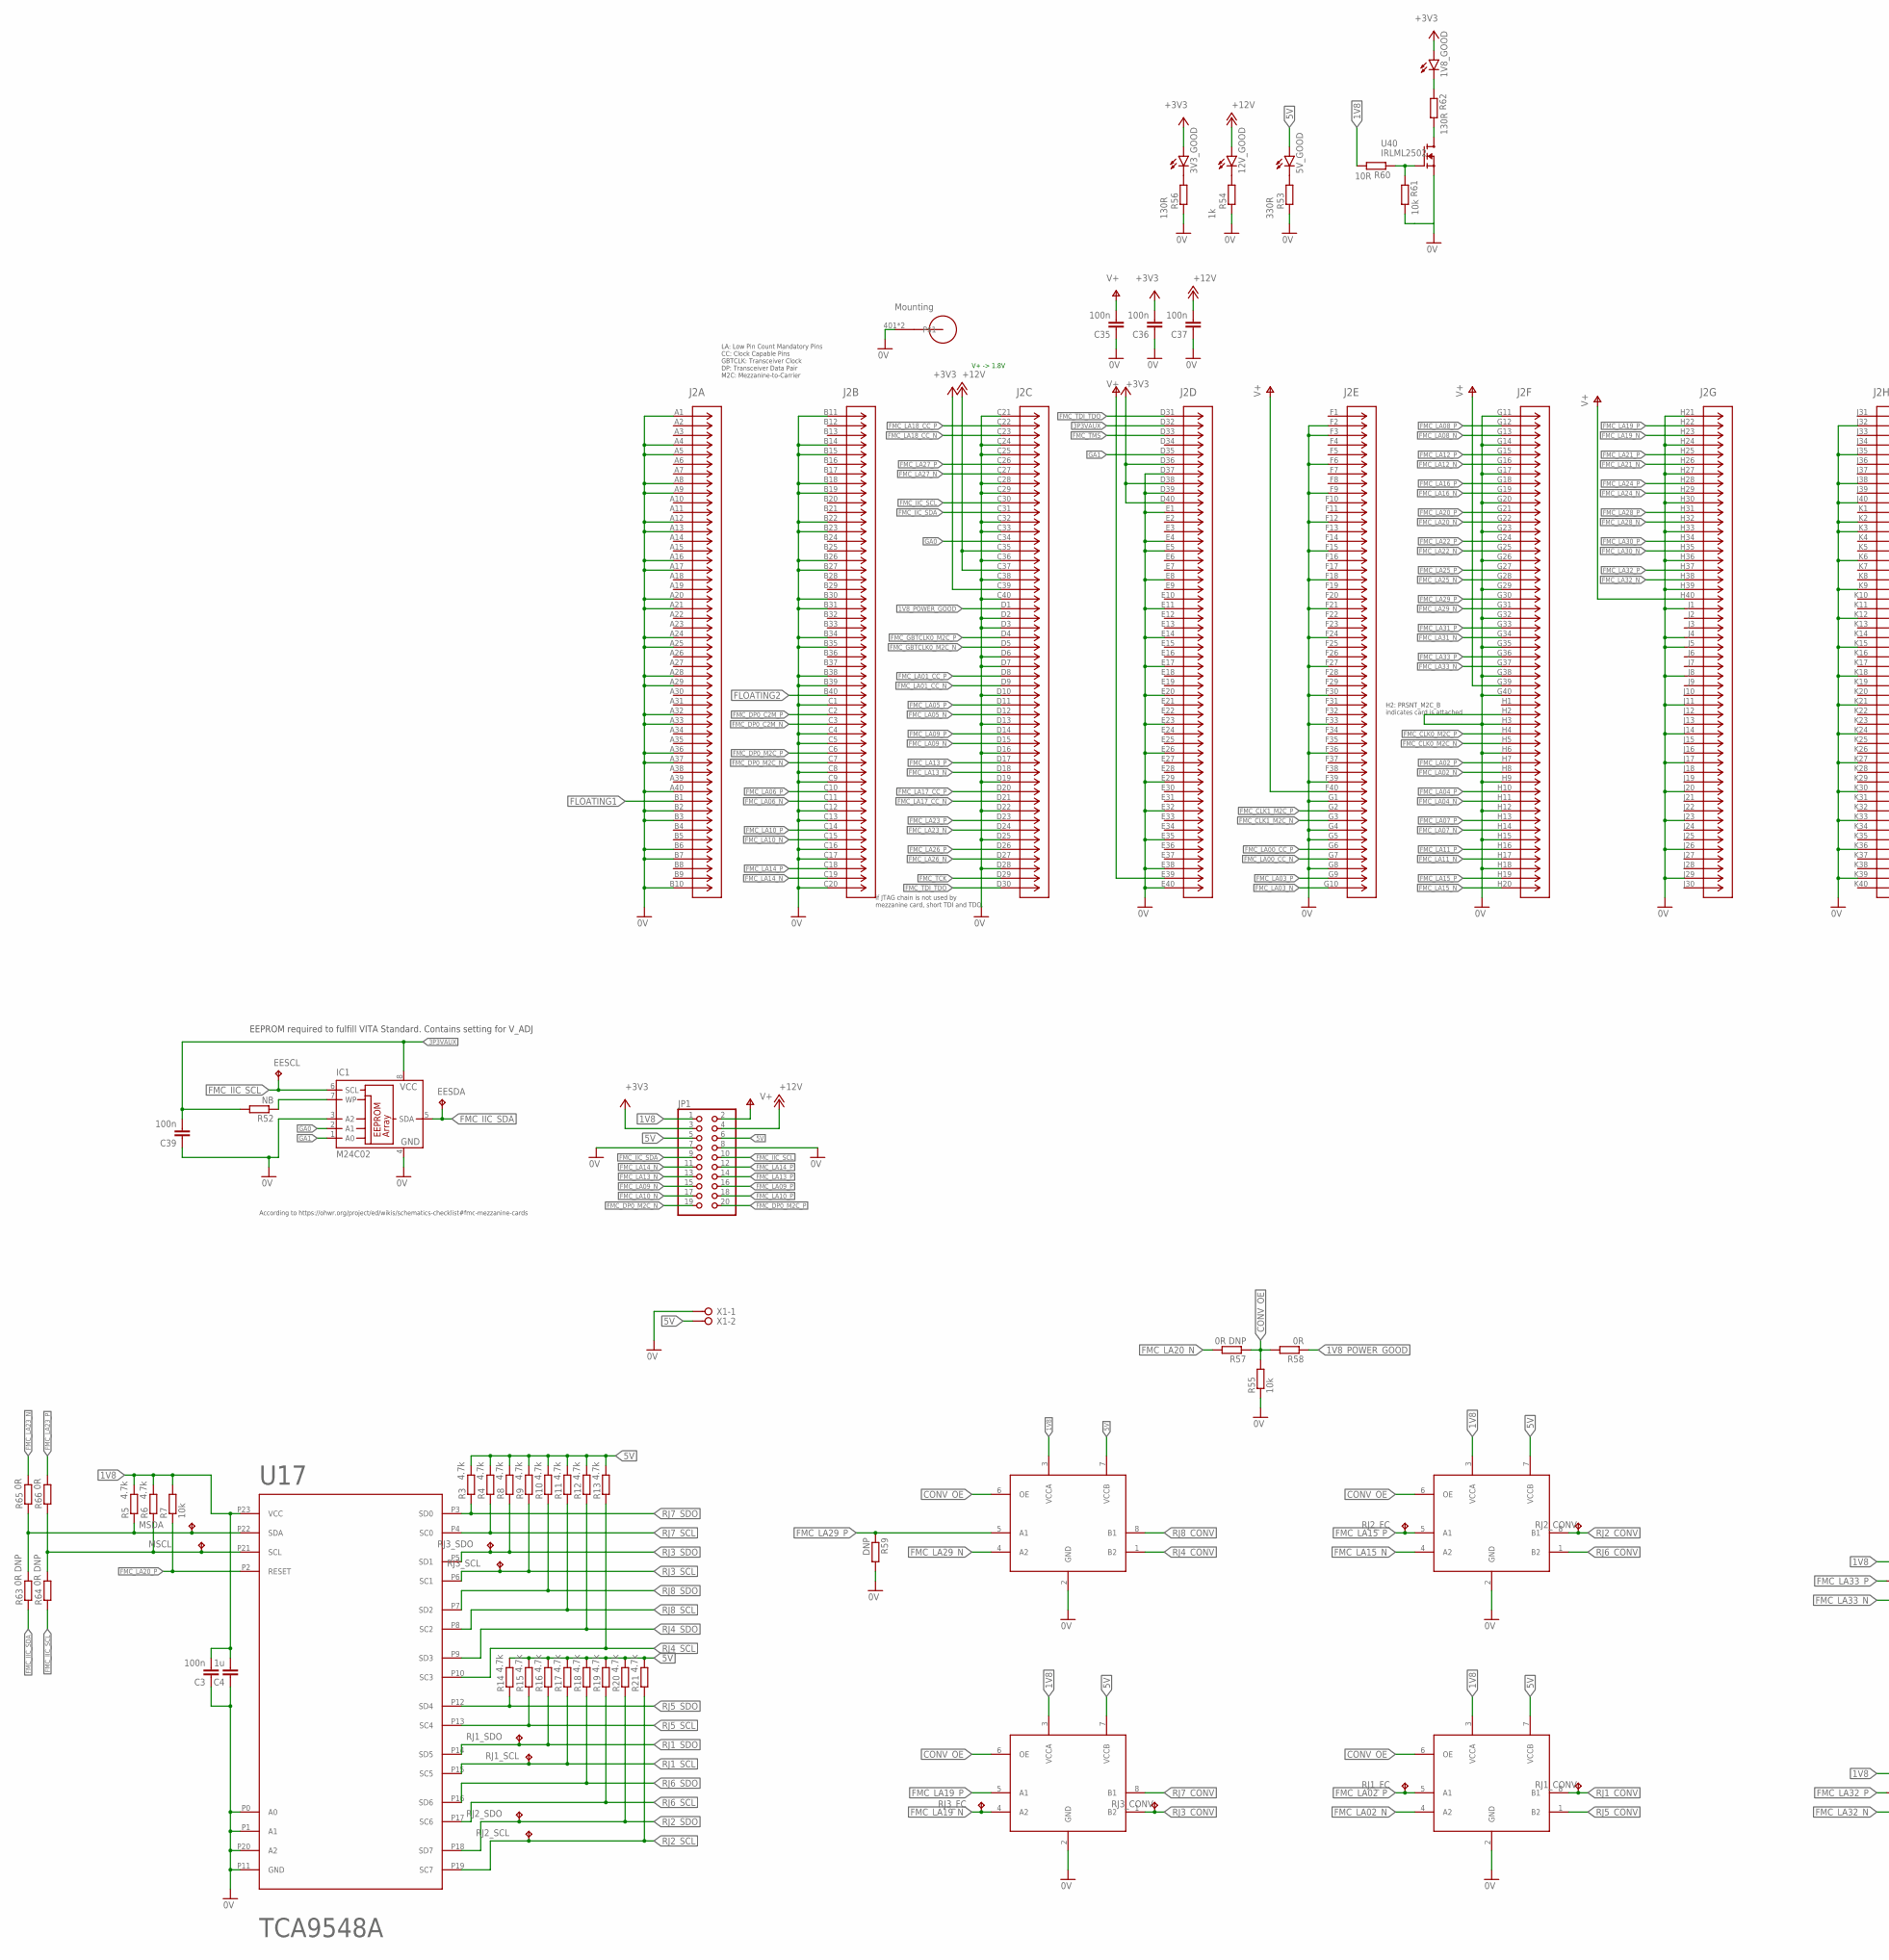
[picture p8: schematic adapter_board.sch, part in row 1, column 1]

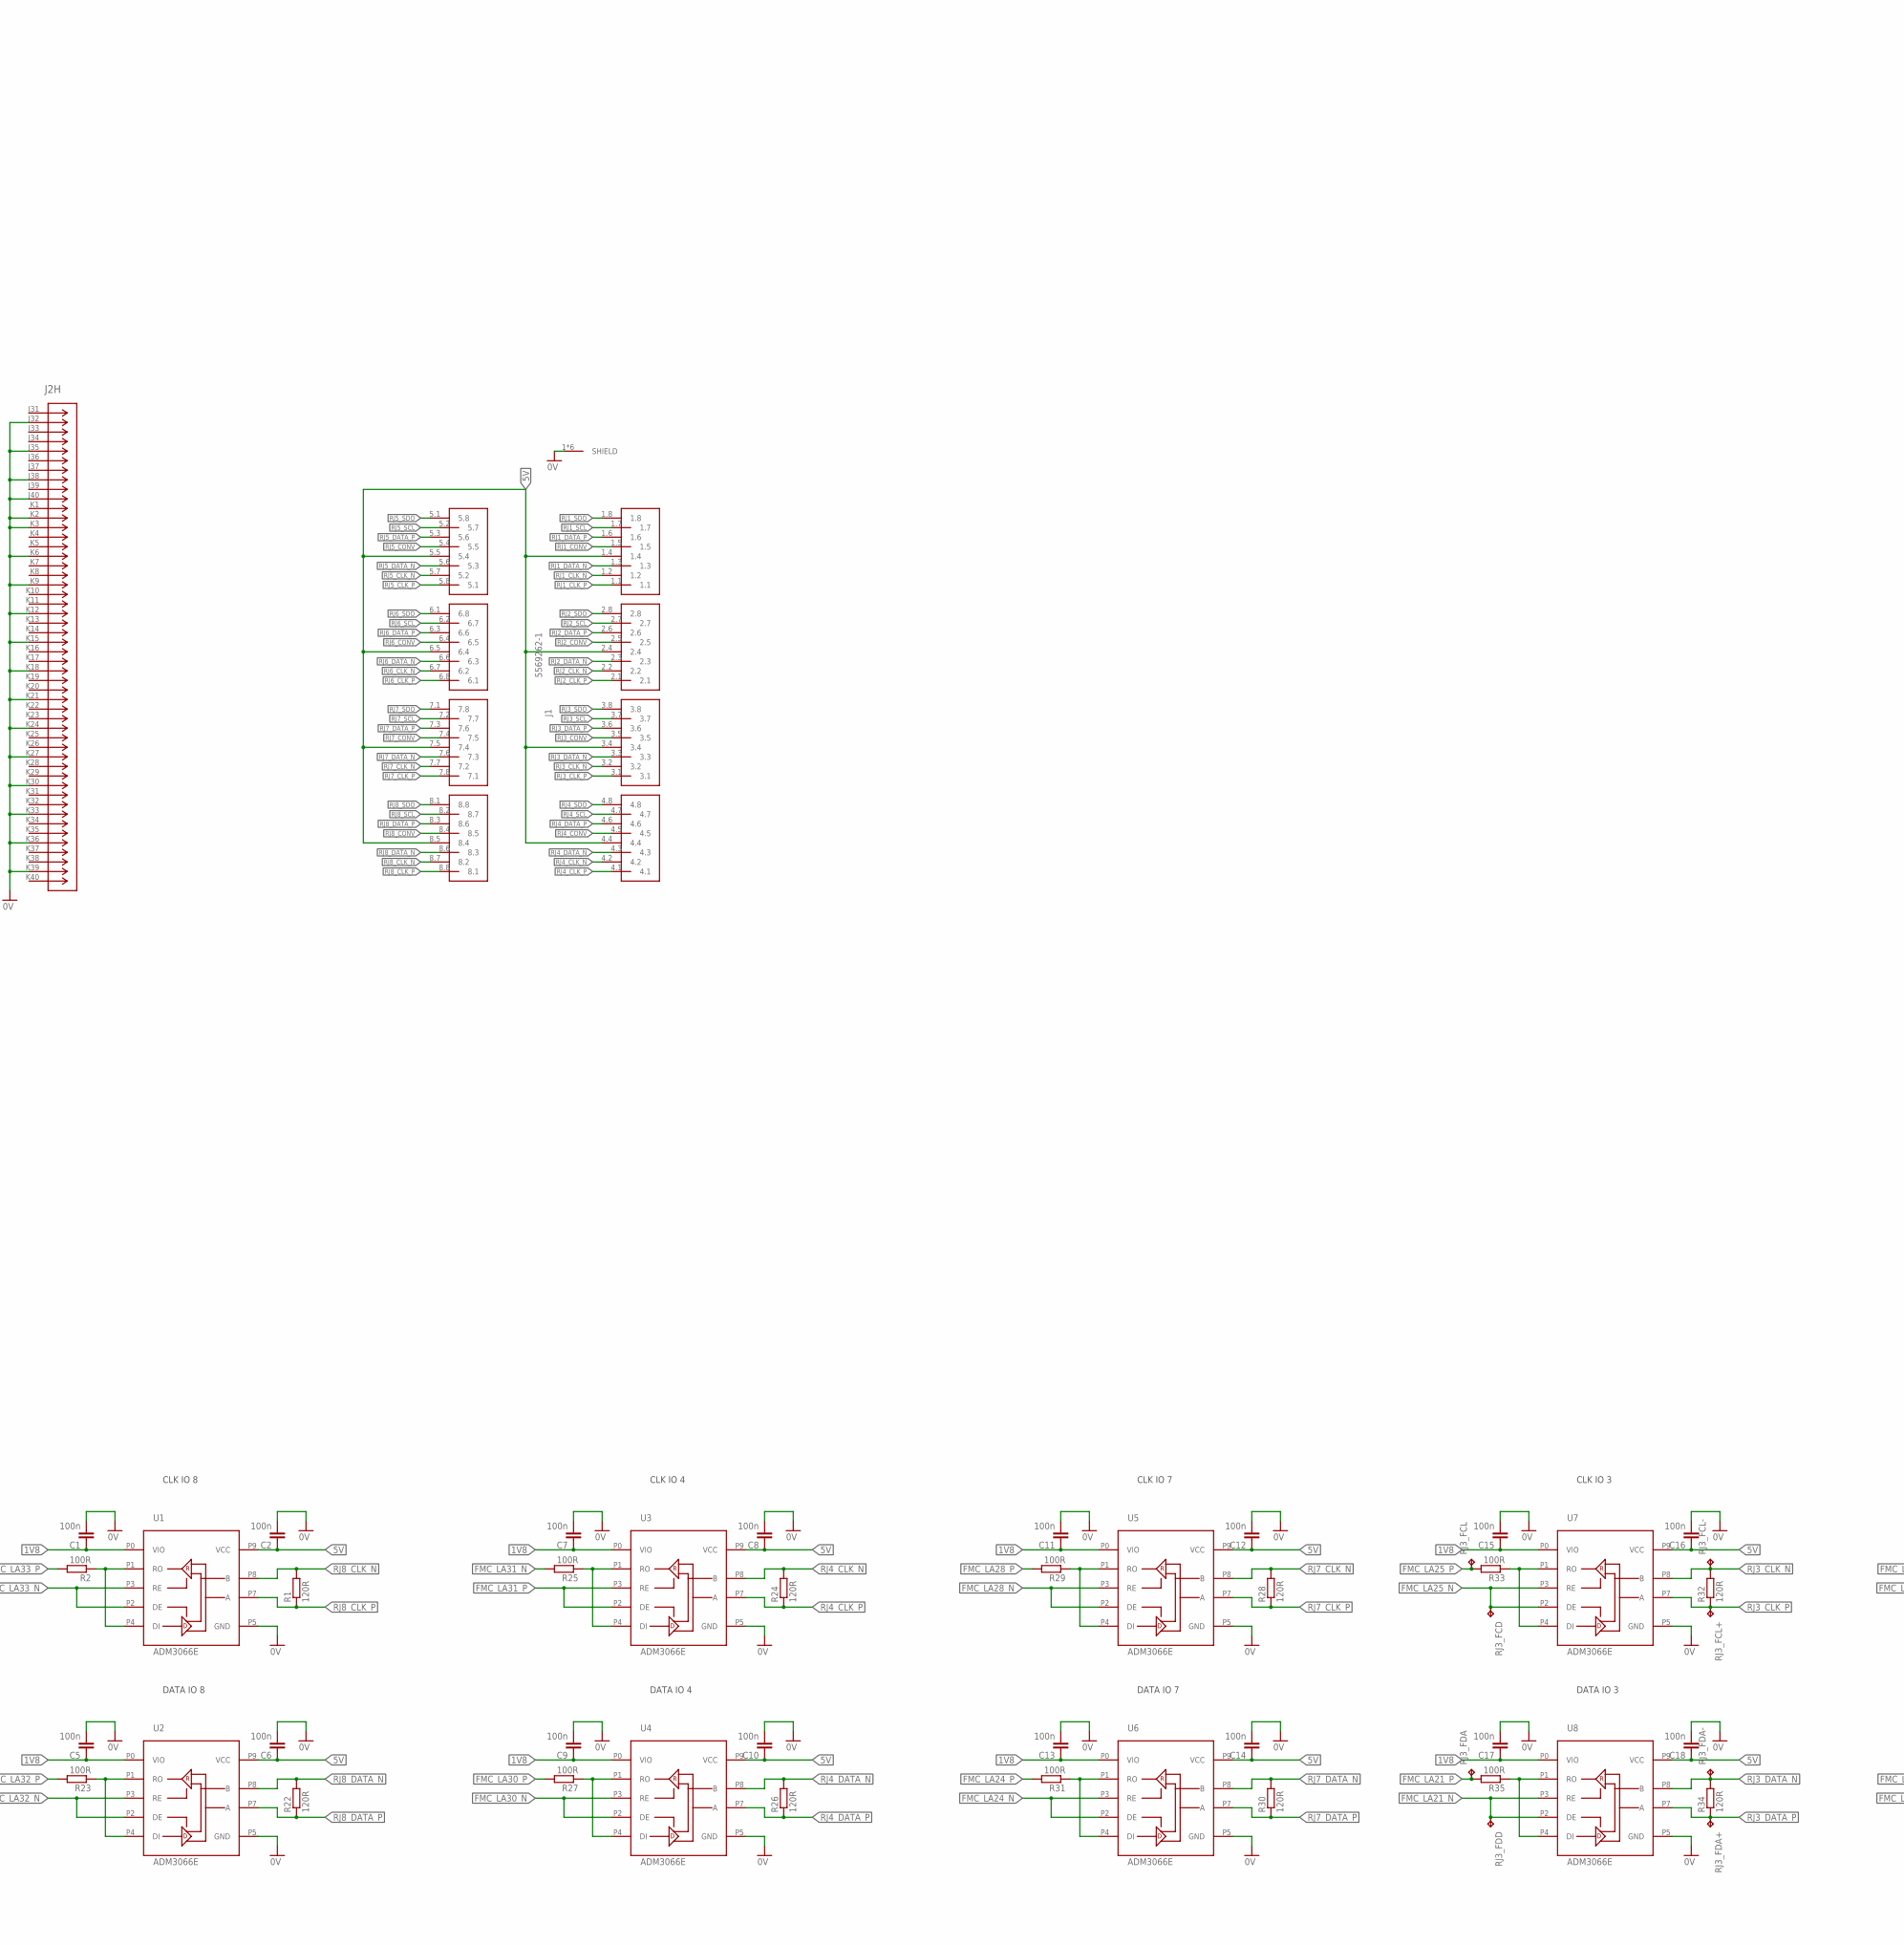
[picture p9: schematic adapter_board.sch, part in row 1, column 2]

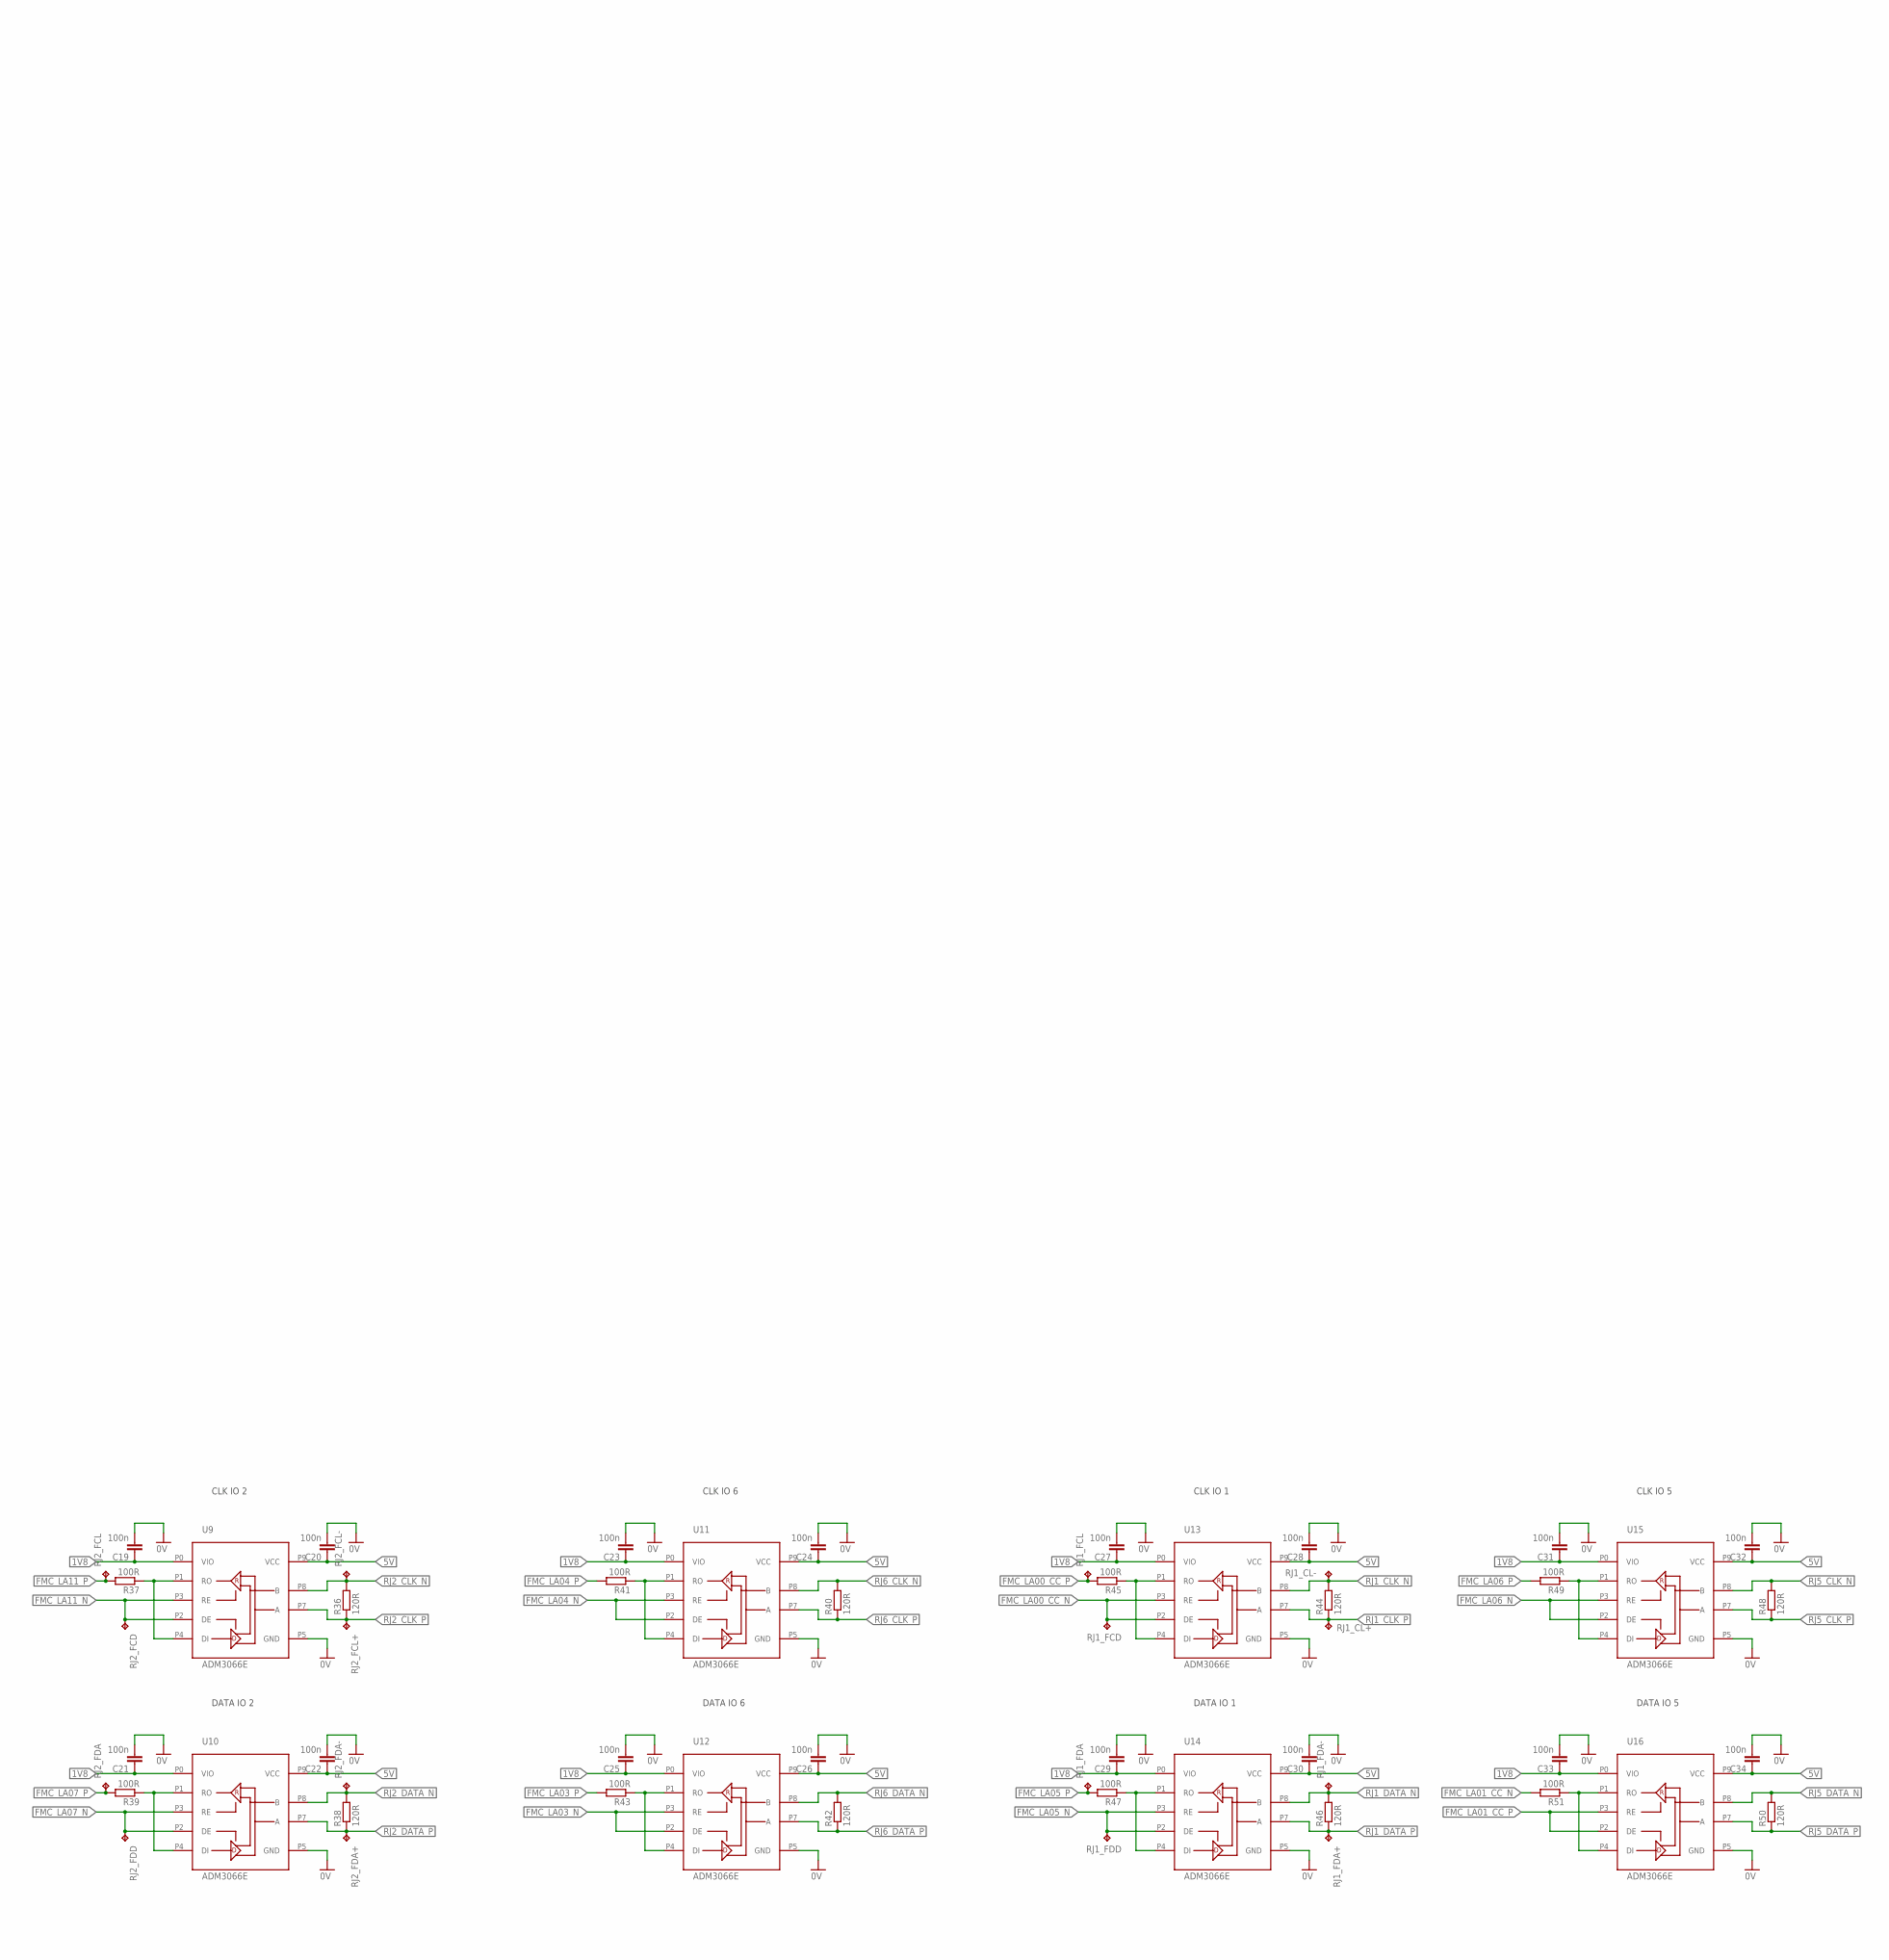
[picture p10: schematic adapter_board.sch, part in row 1, column 3]

Parts:
1V8_GOOD, 3V3_GOOD, 5V_GOOD, 12V_GOOD: LEDCHIPLED_0805; CHIPLED_0805
C1, C2, C5, C6, C7, C8, C9, C10, C11, C12, C13, C14, C15, C16, C17, C18, C19, C20, C21, C22, C23, C24, C25, C26, C27, C28, C29, C30, C31, C32, C33, C34, C35, C36, C37, C39: 100n; C0603
C3: 100n; C0805
C4: 1u; C0805
EESCL: TPB1,27; B1,27
EESDA: TPB1,27; B1,27
IC1: M24C02; TSSOP-8
J1: 5569262-1; TE_5569262-1
J2: ASP-134488-01; CONN_ASP-134488-01_SAI
JP1: PINHD-2X10; 2X10
MSCL: TPB1,27; B1,27
MSDA: TPB1,27; B1,27
R1, R22, R24, R26, R28, R30, R32, R34, R36, R38, R40, R42, R44, R46, R48, R50: 120R; R0805
R2, R23, R25, R27, R29, R31, R33, R35, R37, R39, R41, R43, R45, R47, R49, R51: 100R; R0603
R3, R4, R8, R9, R10, R11, R12, R13, R14, R15, R16, R17, R18, R19, R20, R21: 4.7k; R0805
R5, R6: 4.7k; R0603
R7, R55, R61: 10k; R0603
R52: NB; R0603
R53: 330R; R0805
R54: 1k; R0805
R56, R62: 130R; R0805
R57: 0R DNP; R0603
R58: 0R; R0603
R59: DNP; R0805
R60: 10R; R0603
R63, R64: 0R DNP; R0805
R65, R66: 0R; R0805
RJ1_CL+, RJ1_CL-, RJ1_CONV, RJ1_FC, RJ1_FCD, RJ1_FCL, RJ1_FDA, RJ1_FDA+, RJ1_FDA-, RJ1_FDD, RJ1_SCL, RJ1_SDO, RJ2_CONV, RJ2_FC, RJ2_FCD, RJ2_FCL, RJ2_FCL+, RJ2_FCL-, RJ2_FDA, RJ2_FDA+, RJ2_FDA-, RJ2_FDD, RJ2_SCL, RJ2_SDO, RJ3_CONV, RJ3_FC, RJ3_FCD, RJ3_FCL, RJ3_FCL+, RJ3_FCL-, RJ3_FDA, RJ3_FDA+, RJ3_FDA-, RJ3_FDD, RJ3_SCL, RJ3_SDO: TPB1,27; B1,27
U1, U2, U3, U4, U5, U6, U7, U8, U9, U10, U11, U12, U13, U14, U15, U16: ADM3066E; MSOP-10
U17: TCA9548A; PCA9548
U18, U19, U20, U21: TXS0102; VSSOP-8
U40: IRLML2502; SOT23-IRLML
X1: W237-02P; W237-132

Connections:
0V: C1.2, C2.2, C3.1, C4.1, C5.2, C6.2, C7.2, C8.2, C9.2, C10.2, C11.2, C12.2, C13.2, C14.2, C15.2, C16.2, C17.2, C18.2, C19.2, C20.2, C21.2, C22.2, C23.2, C24.2, C25.2, C26.2, C27.2, C28.2, C29.2, C30.2, C31.2, C32.2, C33.2, C34.2, C35.1, C36.1, C37.1, C39.1, IC1.3 (A2), IC1.4 (GND), J1.1 (SHIELD), J1.2 (SHIELD), J1.3 (SHIELD), J1.4 (SHIELD), J1.5 (SHIELD), J1.6 (SHIELD), J2.401, J2.402, J2.A1, J2.A4, J2.A5, J2.A8, J2.A9, J2.A12, J2.A13, J2.A16, J2.A17, J2.A20, J2.A21, J2.A24, J2.A25, J2.A28, J2.A29, J2.A32, J2.A33, J2.A36, J2.A37, J2.A40, J2.B2, J2.B3, J2.B6, J2.B7, J2.B10, J2.B11, J2.B14, J2.B15, J2.B18, J2.B19, J2.B22, J2.B23, J2.B26, J2.B27, J2.B30, J2.B31, J2.B34, J2.B35, J2.B38, J2.B39, J2.C1, J2.C4, J2.C5, J2.C8, J2.C9, J2.C12, J2.C13, J2.C16, J2.C17, J2.C20, J2.C21, J2.C24, J2.C25, J2.C28, J2.C29, J2.C32, J2.C33, J2.C36, J2.C38, J2.C40, J2.D2, J2.D3, J2.D6, J2.D7, J2.D10, J2.D13, J2.D16, J2.D19, J2.D22, J2.D25, J2.D28, J2.D37, J2.D39, J2.E1, J2.E4, J2.E5, J2.E8, J2.E11, J2.E14, J2.E17, J2.E20, J2.E23, J2.E26, J2.E29, J2.E32, J2.E35, J2.E38, J2.E40, J2.F2, J2.F3, J2.F6, J2.F9, J2.F12, J2.F15, J2.F18, J2.F21, J2.F24, J2.F27, J2.F30, J2.F33, J2.F36, J2.F39, J2.G1, J2.G4, J2.G5, J2.G8, J2.G11, J2.G14, J2.G17, J2.G20, J2.G23, J2.G26, J2.G29, J2.G32, J2.G35, J2.G38, J2.G40, J2.H2, J2.H3, J2.H6, J2.H9, J2.H12, J2.H15, J2.H18, J2.H21, J2.H24, J2.H27, J2.H30, J2.H33, J2.H36, J2.H39, J2.J1, J2.J4, J2.J5, J2.J8, J2.J11, J2.J14, J2.J17, J2.J20, J2.J23, J2.J26, J2.J29, J2.J32, J2.J35, J2.J38, J2.J40, J2.K2, J2.K3, J2.K6, J2.K9, J2.K12, J2.K15, J2.K18, J2.K21, J2.K24, J2.K27, J2.K30, J2.K33, J2.K36, J2.K39, JP1.7, JP1.8, R53.1, R54.1, R55.1, R56.1, R59.2, R61.2, U1.P5 (GND), U2.P5 (GND), U3.P5 (GND), U4.P5 (GND), U5.P5 (GND), U6.P5 (GND), U7.P5 (GND), U8.P5 (GND), U9.P5 (GND), U10.P5 (GND), U11.P5 (GND), U12.P5 (GND), U13.P5 (GND), U14.P5 (GND), U15.P5 (GND), U16.P5 (GND), U17.P0 (A0), U17.P1 (A1), U17.P11 (GND), U17.P20 (A2), U18.2 (GND), U19.2 (GND), U20.2 (GND), U21.2 (GND), U40.P2 (S), X1.1
1V8: C1.1, C3.2, C4.2, C5.1, C7.1, C9.1, C11.1, C13.1, C15.1, C17.1, C19.1, C21.1, C23.1, C25.1, C27.1, C29.1, C31.1, C33.1, JP1.1, R5.2, R6.2, R7.2, R60.2, U1.P0 (VIO), U2.P0 (VIO), U3.P0 (VIO), U4.P0 (VIO), U5.P0 (VIO), U6.P0 (VIO), U7.P0 (VIO), U8.P0 (VIO), U9.P0 (VIO), U10.P0 (VIO), U11.P0 (VIO), U12.P0 (VIO), U13.P0 (VIO), U14.P0 (VIO), U15.P0 (VIO), U16.P0 (VIO), U17.P23 (VCC), U18.3 (VCCA), U19.3 (VCCA), U20.3 (VCCA), U21.3 (VCCA)
1V8_POWER_GOOD: J2.D1, R58.1
3P3VAUX: C39.2, IC1.8 (VCC), J2.D32, R52.2
5V: 5V_GOOD.A, C2.1, C6.1, C8.1, C10.1, C12.1, C14.1, C16.1, C18.1, C20.1, C22.1, C24.1, C26.1, C28.1, C30.1, C32.1, C34.1, J1.1.4, J1.2.4, J1.3.4, J1.4.4, J1.5.5 (5.4), J1.6.5 (6.4), J1.7.5 (7.4), J1.8.5 (8.4), JP1.5, JP1.6, R3.2, R4.2, R8.2, R9.2, R10.2, R11.2, R12.2, R13.2, R14.2, R15.2, R16.2, R17.2, R18.2, R19.2, R20.2, R21.2, U1.P9 (VCC), U2.P9 (VCC), U3.P9 (VCC), U4.P9 (VCC), U5.P9 (VCC), U6.P9 (VCC), U7.P9 (VCC), U8.P9 (VCC), U9.P9 (VCC), U10.P9 (VCC), U11.P9 (VCC), U12.P9 (VCC), U13.P9 (VCC), U14.P9 (VCC), U15.P9 (VCC), U16.P9 (VCC), U18.7 (VCCB), U19.7 (VCCB), U20.7 (VCCB), U21.7 (VCCB), X1.2
+3V3: 1V8_GOOD.A, 3V3_GOOD.A, C36.2, J2.C39, J2.D36, J2.D38, J2.D40, JP1.3
+12V: 12V_GOOD.A, C37.2, J2.C35, J2.C37, JP1.4
CONV_OE: R55.2, R57.1, R58.2, U18.6 (OE), U19.6 (OE), U20.6 (OE), U21.6 (OE)
FLOATING1: J2.B1
FLOATING2: J2.B40
FMC_CLK0_M2C_N: J2.H5
FMC_CLK0_M2C_P: J2.H4
FMC_CLK1_M2C_N: J2.G3
FMC_CLK1_M2C_P: J2.G2
FMC_DP0_C2M_N: J2.C3
FMC_DP0_C2M_P: J2.C2
FMC_DP0_M2C_N: J2.C7, JP1.19
FMC_DP0_M2C_P: J2.C6, JP1.20
FMC_GBTCLK0_M2C_N: J2.D5
FMC_GBTCLK0_M2C_P: J2.D4
FMC_IIC_SCL: EESCL.TP, IC1.6 (SCL), J2.C30, JP1.10, R64.1
FMC_IIC_SDA: EESDA.TP, IC1.5 (SDA), J2.C31, JP1.9, R63.1
FMC_LA00_CC_N: J2.G7, RJ1_FCD.TP, U13.P2 (DE), U13.P3 (RE)
FMC_LA00_CC_P: J2.G6, R45.2, RJ1_FCL.TP
FMC_LA01_CC_N: J2.D9, R51.2
FMC_LA01_CC_P: J2.D8, U16.P2 (DE), U16.P3 (RE)
FMC_LA02_N: J2.H8, U21.4 (A2)
FMC_LA02_P: J2.H7, RJ1_FC.TP, U21.5 (A1)
FMC_LA03_N: J2.G10, U12.P2 (DE), U12.P3 (RE)
FMC_LA03_P: J2.G9, R43.2
FMC_LA04_N: J2.H11, U11.P2 (DE), U11.P3 (RE)
FMC_LA04_P: J2.H10, R41.2
FMC_LA05_N: J2.D12, RJ1_FDD.TP, U14.P2 (DE), U14.P3 (RE)
FMC_LA05_P: J2.D11, R47.2, RJ1_FDA.TP
FMC_LA06_N: J2.C11, U15.P2 (DE), U15.P3 (RE)
FMC_LA06_P: J2.C10, R49.2
FMC_LA07_N: J2.H14, RJ2_FDD.TP, U10.P2 (DE), U10.P3 (RE)
FMC_LA07_P: J2.H13, R39.2, RJ2_FDA.TP
FMC_LA08_N: J2.G13
FMC_LA08_P: J2.G12
FMC_LA09_N: J2.D15, JP1.15
FMC_LA09_P: J2.D14, JP1.16
FMC_LA10_N: J2.C15, JP1.17
FMC_LA10_P: J2.C14, JP1.18
FMC_LA11_N: J2.H17, RJ2_FCD.TP, U9.P2 (DE), U9.P3 (RE)
FMC_LA11_P: J2.H16, R37.2, RJ2_FCL.TP
FMC_LA12_N: J2.G16
FMC_LA12_P: J2.G15
FMC_LA13_N: J2.D18, JP1.13
FMC_LA13_P: J2.D17, JP1.14
FMC_LA14_N: J2.C19, JP1.11
FMC_LA14_P: J2.C18, JP1.12
FMC_LA15_N: J2.H20, U20.4 (A2)
FMC_LA15_P: J2.H19, RJ2_FC.TP, U20.5 (A1)
FMC_LA16_N: J2.G19
FMC_LA16_P: J2.G18
FMC_LA17_CC_N: J2.D21
FMC_LA17_CC_P: J2.D20
FMC_LA18_CC_N: J2.C23
FMC_LA18_CC_P: J2.C22
FMC_LA19_N: J2.H23, RJ3_FC.TP, U19.4 (A2)
FMC_LA19_P: J2.H22, U19.5 (A1)
FMC_LA20_N: J2.G22, R57.2
FMC_LA20_P: J2.G21, R7.1, U17.P2 (RESET)
FMC_LA21_N: J2.H26, RJ3_FDD.TP, U8.P2 (DE), U8.P3 (RE)
FMC_LA21_P: J2.H25, R35.2, RJ3_FDA.TP
FMC_LA22_N: J2.G25
FMC_LA22_P: J2.G24
FMC_LA23_N: J2.D24, R65.2
FMC_LA23_P: J2.D23, R66.2
FMC_LA24_N: J2.H29, U6.P2 (DE), U6.P3 (RE)
FMC_LA24_P: J2.H28, R31.2
FMC_LA25_N: J2.G28, RJ3_FCD.TP, U7.P2 (DE), U7.P3 (RE)
FMC_LA25_P: J2.G27, R33.2, RJ3_FCL.TP
FMC_LA26_N: J2.D27
FMC_LA26_P: J2.D26
FMC_LA27_N: J2.C27
FMC_LA27_P: J2.C26
FMC_LA28_N: J2.H32, U5.P2 (DE), U5.P3 (RE)
FMC_LA28_P: J2.H31, R29.2
FMC_LA29_N: J2.G31, U18.4 (A2)
FMC_LA29_P: J2.G30, R59.1, U18.5 (A1)
FMC_LA30_N: J2.H35, U4.P2 (DE), U4.P3 (RE)
FMC_LA30_P: J2.H34, R27.2
FMC_LA31_N: J2.G34, R25.2
FMC_LA31_P: J2.G33, U3.P2 (DE), U3.P3 (RE)
FMC_LA32_N: J2.H38, U2.P2 (DE), U2.P3 (RE)
FMC_LA32_P: J2.H37, R23.2
FMC_LA33_N: J2.G37, U1.P2 (DE), U1.P3 (RE)
FMC_LA33_P: J2.G36, R2.2
FMC_TCK: J2.D29
FMC_TDI_TDO: J2.D30, J2.D31
FMC_TMS: J2.D33
GA0: IC1.2 (A1), J2.C34
GA1: IC1.1 (A0), J2.D35
I2C_SCL: MSCL.TP, R6.1, R64.2, R66.1, U17.P21 (SCL)
I2C_SDA: MSDA.TP, R5.1, R63.2, R65.1, U17.P22 (SDA)
LSIO1: R2.1, U1.P1 (RO), U1.P4 (DI)
LSIO2: R23.1, U2.P1 (RO), U2.P4 (DI)
LSIO3: R25.1, U3.P1 (RO), U3.P4 (DI)
LSIO4: R27.1, U4.P1 (RO), U4.P4 (DI)
LSIO5: R29.1, U5.P1 (RO), U5.P4 (DI)
LSIO6: R31.1, U6.P1 (RO), U6.P4 (DI)
LSIO7: R33.1, U7.P1 (RO), U7.P4 (DI)
LSIO8: R35.1, U8.P1 (RO), U8.P4 (DI)
LSIO9: R37.1, U9.P1 (RO), U9.P4 (DI)
LSIO10: R39.1, U10.P1 (RO), U10.P4 (DI)
LSIO11: R41.1, U11.P1 (RO), U11.P4 (DI)
LSIO12: R43.1, U12.P1 (RO), U12.P4 (DI)
LSIO13: R45.1, U13.P1 (RO), U13.P4 (DI)
LSIO14: R47.1, U14.P1 (RO), U14.P4 (DI)
LSIO15: R49.1, U15.P1 (RO), U15.P4 (DI)
LSIO16: R51.1, U16.P1 (RO), U16.P4 (DI)
unnamed: IC1.7 (WP), R52.1
unnamed: 12V_GOOD.C, R54.2
unnamed: 3V3_GOOD.C, R56.2
unnamed: 5V_GOOD.C, R53.2
unnamed: R60.1, R61.1, U40.P1 (G)
unnamed: R62.2, U40.P3 (D)
unnamed: 1V8_GOOD.C, R62.1
RJ1_CLK_N: J1.1.2, R44.2, RJ1_CL-.TP, U13.P8 (B)
RJ1_CLK_P: J1.1.1, R44.1, RJ1_CL+.TP, U13.P7 (A)
RJ1_CONV: J1.1.5, RJ1_CONV.TP, U21.8 (B1)
RJ1_DATA_N: J1.1.3, R46.2, RJ1_FDA-.TP, U14.P8 (B)
RJ1_DATA_P: J1.1.6, R46.1, RJ1_FDA+.TP, U14.P7 (A)
RJ1_SCL: J1.1.7, R17.1, RJ1_SCL.TP, U17.P15 (SC5)
RJ1_SDO: J1.1.8, R16.1, RJ1_SDO.TP, U17.P14 (SD5)
RJ2_CLK_N: J1.2.2, R36.2, RJ2_FCL-.TP, U9.P8 (B)
RJ2_CLK_P: J1.2.1, R36.1, RJ2_FCL+.TP, U9.P7 (A)
RJ2_CONV: J1.2.5, RJ2_CONV.TP, U20.8 (B1)
RJ2_DATA_N: J1.2.3, R38.2, RJ2_FDA-.TP, U10.P8 (B)
RJ2_DATA_P: J1.2.6, R38.1, RJ2_FDA+.TP, U10.P7 (A)
RJ2_SCL: J1.2.7, R21.1, RJ2_SCL.TP, U17.P19 (SC7)
RJ2_SDO: J1.2.8, R20.1, RJ2_SDO.TP, U17.P18 (SD7)
RJ3_CLK_N: J1.3.2, R32.2, RJ3_FCL-.TP, U7.P8 (B)
RJ3_CLK_P: J1.3.1, R32.1, RJ3_FCL+.TP, U7.P7 (A)
RJ3_CONV: J1.3.5, RJ3_CONV.TP, U19.1 (B2)
RJ3_DATA_N: J1.3.3, R34.2, RJ3_FDA-.TP, U8.P8 (B)
RJ3_DATA_P: J1.3.6, R34.1, RJ3_FDA+.TP, U8.P7 (A)
RJ3_SCL: J1.3.7, R9.1, RJ3_SCL.TP, U17.P6 (SC1)
RJ3_SDO: J1.3.8, R8.1, RJ3_SDO.TP, U17.P5 (SD1)
RJ4_CLK_N: J1.4.2, R24.2, U3.P8 (B)
RJ4_CLK_P: J1.4.1, R24.1, U3.P7 (A)
RJ4_CONV: J1.4.5, U18.1 (B2)
RJ4_DATA_N: J1.4.3, R26.2, U4.P8 (B)
RJ4_DATA_P: J1.4.6, R26.1, U4.P7 (A)
RJ4_SCL: J1.4.7, R13.1, U17.P10 (SC3)
RJ4_SDO: J1.4.8, R12.1, U17.P9 (SD3)
RJ5_CLK_N: J1.5.7 (5.2), R48.2, U15.P8 (B)
RJ5_CLK_P: J1.5.8 (5.1), R48.1, U15.P7 (A)
RJ5_CONV: J1.5.4 (5.5), U21.1 (B2)
RJ5_DATA_N: J1.5.6 (5.3), R50.2, U16.P8 (B)
RJ5_DATA_P: J1.5.3 (5.6), R50.1, U16.P7 (A)
RJ5_SCL: J1.5.2 (5.7), R15.1, U17.P13 (SC4)
RJ5_SDO: J1.5.1 (5.8), R14.1, U17.P12 (SD4)
RJ6_CLK_N: J1.6.7 (6.2), R40.2, U11.P8 (B)
RJ6_CLK_P: J1.6.8 (6.1), R40.1, U11.P7 (A)
RJ6_CONV: J1.6.4 (6.5), U20.1 (B2)
RJ6_DATA_N: J1.6.6 (6.3), R42.2, U12.P8 (B)
RJ6_DATA_P: J1.6.3 (6.6), R42.1, U12.P7 (A)
RJ6_SCL: J1.6.2 (6.7), R19.1, U17.P17 (SC6)
RJ6_SDO: J1.6.1 (6.8), R18.1, U17.P16 (SD6)
RJ7_CLK_N: J1.7.7 (7.2), R28.2, U5.P8 (B)
RJ7_CLK_P: J1.7.8 (7.1), R28.1, U5.P7 (A)
RJ7_CONV: J1.7.4 (7.5), U19.8 (B1)
RJ7_DATA_N: J1.7.6 (7.3), R30.2, U6.P8 (B)
RJ7_DATA_P: J1.7.3 (7.6), R30.1, U6.P7 (A)
RJ7_SCL: J1.7.2 (7.7), R4.1, U17.P4 (SC0)
RJ7_SDO: J1.7.1 (7.8), R3.1, U17.P3 (SD0)
RJ8_CLK_N: J1.8.7 (8.2), R1.2, U1.P8 (B)
RJ8_CLK_P: J1.8.8 (8.1), R1.1, U1.P7 (A)
RJ8_CONV: J1.8.4 (8.5), U18.8 (B1)
RJ8_DATA_N: J1.8.6 (8.3), R22.2, U2.P8 (B)
RJ8_DATA_P: J1.8.3 (8.6), R22.1, U2.P7 (A)
RJ8_SCL: J1.8.2 (8.7), R11.1, U17.P8 (SC2)
RJ8_SDO: J1.8.1 (8.8), R10.1, U17.P7 (SD2)
V+: C35.2, J2.E39, J2.F40, J2.G39, J2.H40, JP1.2

Notes on the sheet:
V+ -> 1.8V
LA: Low Pin Count Mandatory Pins CC: Clock Capable Pins GBTCLK: Transceiver Clock DP: Transceiver Data Pair M2C: Mezzanine-to-Carrier
if JTAG chain is not used by mezzanine card, short TDI and TDO.
H2: PRSNT_M2C_B indicates card is attached
CLK IO 8
DATA IO 8
CLK IO 4
DATA IO 4
CLK IO 7
DATA IO 7
CLK IO 3
DATA IO 3
EEPROM required to fulfill VITA Standard. Contains setting for V_ADJ
CLK IO 2
DATA IO 2
CLK IO 6
DATA IO 6
CLK IO 1
DATA IO 1
CLK IO 5
DATA IO 5
According to https://ohwr.org/project/ed/wikis/schematics-checklist#fmc-mezzanine-cards

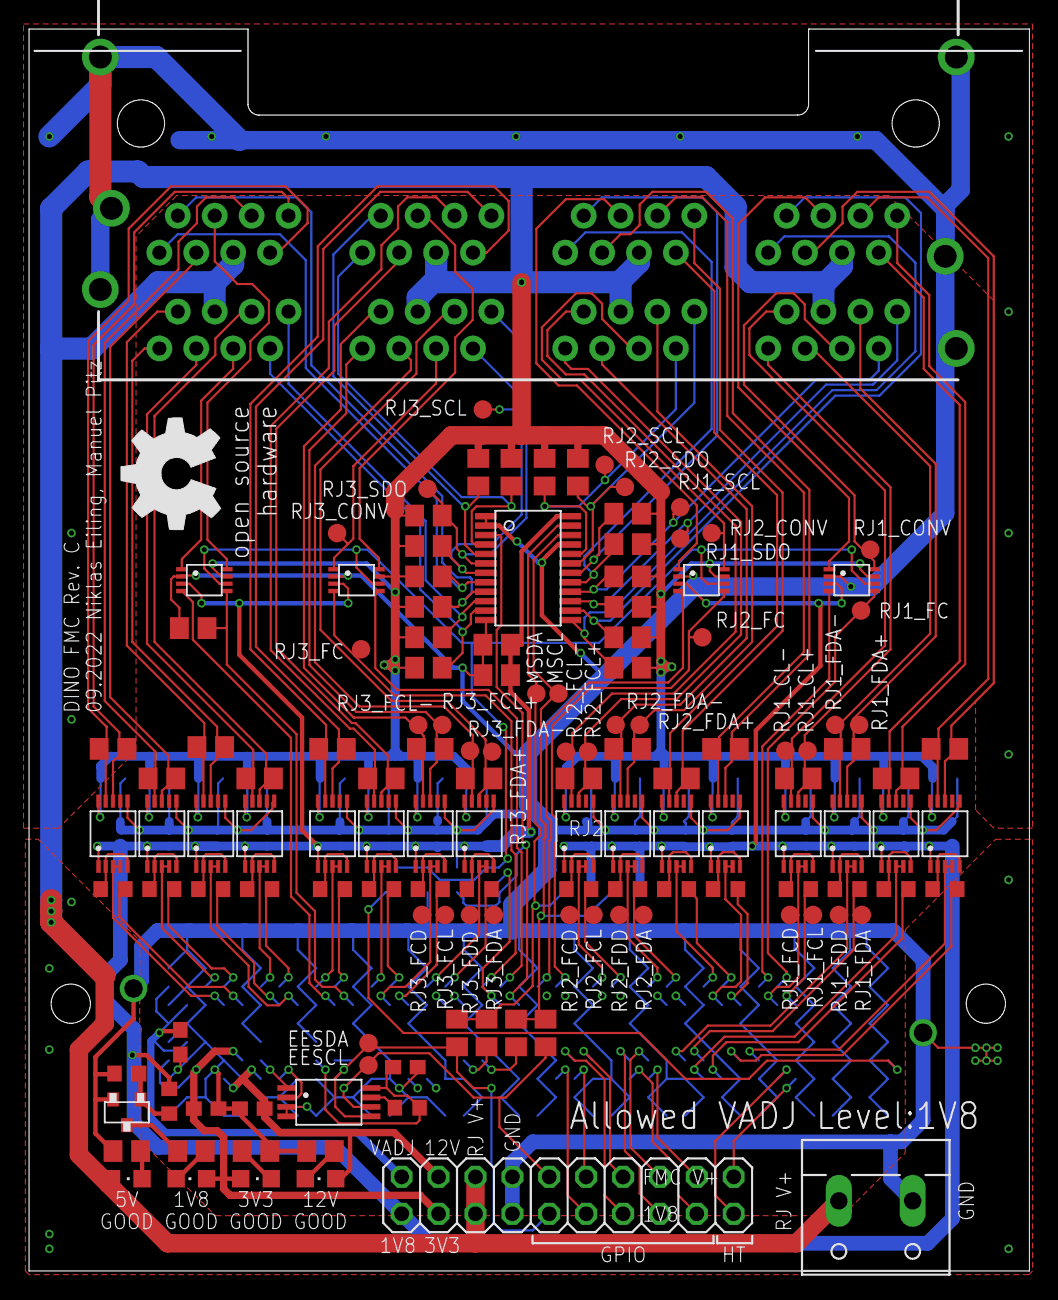
[picture p11: board adapter_board.brd from above]

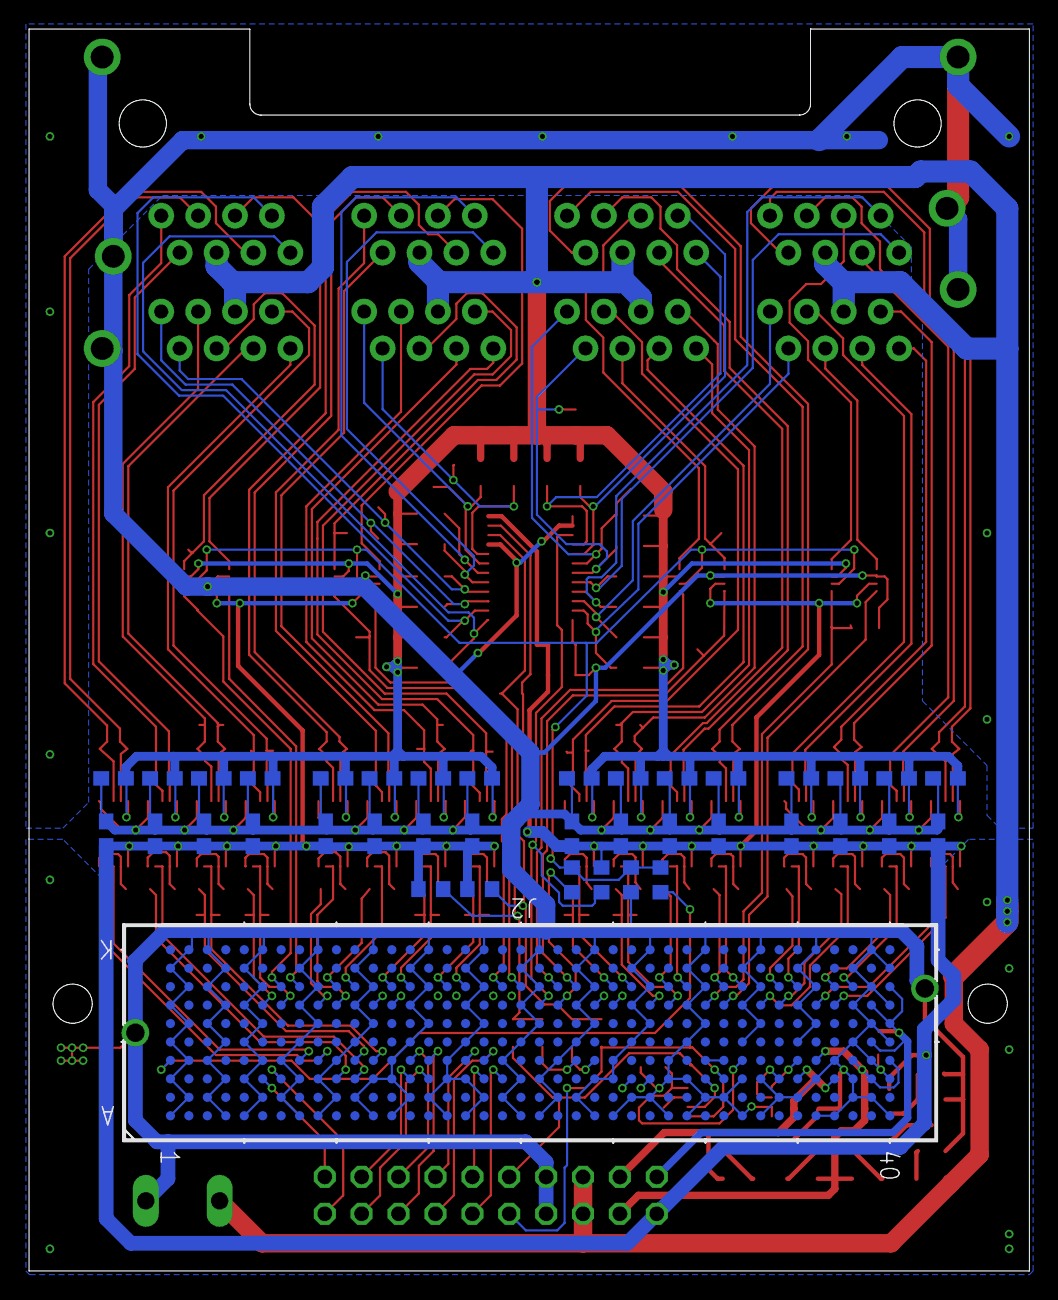
[picture p12: board adapter_board.brd from below]

Board: 2 copper layers, 68.9 x 85.5 mm, 176 parts (39 on the bottom side), 149 nets.

Other parts of the board:
U$1: OSHW_8MM
