RWTH-ACS/dino/(commit log)

2021-11-26 add analog-in pcb
    [analog-in.brd, analog-in.csv, analog-in.sch]
2021-11-26 initial commit. Adding analog in hardware, corresponding software and fpga design, draft for fmc hardware, etc.
    [adapter_board.brd, adapter_board.sch, analog-in-bom.csv]
2021-11-26 fpga-fmc: add LPC pin assignment of FMC connector
    [adapter_board.brd, adapter_board.sch]
2021-11-26 fpga-fmc: fix board layout
    [adapter_board.brd, adapter_board.sch]
2021-11-26 fpga-fmc: add devices from analog-in pcb
    [adapter_board.brd, adapter_board.sch]
2021-11-26 fpga-fmc: add more isolator ics. add i2c switch ic
    [adapter_board.brd, adapter_board.sch]
2021-11-26 fpga-fmc: add 4 channel isolator ic
    [adapter_board.brd, adapter_board.sch]
2021-12-03 analog-in: add comments with PCB mistakes
    [analog-in.sch]
2021-12-03 sw/arduino: add i2c functions, verify i2c functionality, read saturation check
2021-12-03 sw/arduino: add error compensation
    [analog-in.ino]
2021-12-10 hw/analog-in: add mistake comment
    [analog-in.sch]
2021-12-10 hw/fpga-fmc: add and route rs485 transceiver for 3 channels
    [DRILEGEND.CFG, adapter_board.brd, adapter_board.sch]
2021-12-10 sw/arduino/analog-in: work on arduino test sw
2021-12-13 fpga-fmc: add i2c circuit and level shifter for conv signal
    [adapter_board.brd, adapter_board.sch]
2021-12-14 fpga_fmc: route conv signals and more rj channels
    [adapter_board.brd, adapter_board.sch]
2021-12-15 fpga-fmc: route right side
    [adapter_board.brd, adapter_board.sch]
2022-01-06 hw/fpga-fmc: add 5V supply and route remaining CONV signals
    [adapter_board.brd, adapter_board.sch]
2022-02-17 arduino/analog-in: make arduino led blink, improve comments
2022-05-02 hw/fpga-fmc: finalize pcb design and prepare BOM
    [adapter_board.brd, adapter_board.csv, adapter_board.sch]
2022-05-03 hw/fpga-fmc: fix clearance issues
    [adapter_board.brd, adapter_board.csv, adapter_board.sch]
2022-06-07 hw/fpga-fmc: fix connector turned by 180 degrees. add led for 1v8. change i2c package
    [adapter_board.brd, adapter_board.csv, adapter_board.sch]
2022-06-07 sw/arduino/analog-in: work on arduino sw
2022-06-07 hdl: copy all pin assignments to constraint file
    note: RJ8 FMC connection are not connected on the FPGA board, so RJ8 cannot be used with the prototype pcb
    [adapter_board.brd, adapter_board.sch]
2022-08-02 turn FMC connector and reroute signals
    [adapter_board.brd, adapter_board.sch]
2022-08-04 hw/fpga-fmc: rewire pin header and screw terminal.
    [adapter_board.brd, adapter_board.sch]
2022-08-08 hw/fpga-fmc: reposition i2c switch
    [adapter_board.brd]
2022-08-25 hw/fpga-fmc: optimize routing
    [adapter_board.brd, adapter_board.sch]
2022-08-25 sw/arduino/analog-in: improve error output
    [analog-in.ino]
2022-08-25 hdl/vivado: update constraints to deactivate wrongly routed channels
    [villassensorif.xdc]
2022-08-26 hw/analog-in: fix mistakes from rev 1
    [analog-in.brd, analog-in.sch]
2022-08-26 hw/fmc minor cleanup in layout and schematic
    [adapter_board.brd, adapter_board.sch]
2022-08-26 hw/fpga-fmc: align GND vias
    [adapter_board.brd]
2022-08-29 hw/fpga-fmc: make rs485 termination resistors 0805 for better power rating
    [adapter_board.brd, adapter_board.sch]
2022-09-08 hw: add analog-out as copy of analog-in
    [analog-out.brd, analog-out.sch]
2022-09-08 ADC board fixes
    [analog-in.brd, analog-in.sch]
2022-09-13 hw/fpga-fmc: fix wrong connection on bottom row rj-45 connectors
    [adapter_board.brd, adapter_board.sch]
2022-09-19 hw/fpga-fmc: fix more issues on adapter board
    [adapter_board.brd]
2022-09-19 hdl/vivado: change for rev B PCB
2022-11-03 hw/analog-in: update schematics for analog in
    [analog-in.brd, analog-in.sch]
2022-11-03 hw/fpga-fmc: make i2c bus id configurable in fmceeprom_write.c
2022-11-03 First verision of dac schematic
    [analog-out.brd, analog-out.sch]
2022-11-03 hw/fpga-fmc/eeprom: fix wrong arg number check
    [fmceeprom_write.c]
2022-11-28 hdl: add dinoif_fast_tb that simulates the dino ADC, edge injection logic and delay lines
2022-11-28 hdl: verify and fix dinoif_fast
    [dinoif_fast.vhd, dinoif_fast_tb.vhd]
2022-12-12 hdl/vivado: add i2c IP to design
2022-12-12 hw/analog-in: add note
    [analog-in.sch]
2023-08-14 first revision of dac board
    [analog-out.brd, analog-out.sch]
2023-08-14 add polygon
    [analog-out.brd]
2023-10-13 updated version of board and schematic
    [analog-out.brd, analog-out.sch]
2023-10-16 hw: change isolator to si8400ab
    [analog-in.brd, analog-in.sch, analog-out.brd, analog-out.sch]
2023-10-16 hw: fix part numbers
    [analog-out.brd, analog-out.sch]
2023-10-23 hdl: add dac and fix adc IP
    [dinoif_dac.vhd, dinoif_dac_tb.vhd, dinoif_fast.vhd]
2023-10-25 hdl: update board design
2023-12-05 sw/dino-config: add code to configure dino via i2c from SoC
2024-04-16 move eagle
    [DRILEGEND.CFG, adapter_board.brd, adapter_board.csv, adapter_board.sch, analog-in-bom.csv, analog-in.brd, analog-in.sch, analog-out.brd]
2024-04-16 add kicad
    [analog-in.kicad_pcb, analog-in.kicad_sch, analog-out.kicad_pcb, analog-out.kicad_sch]
2024-04-16 update adc to latest version
    [analog-in.kicad_sch]
2024-04-18 hdl: fix design to work with LTC2314 ADC
    [dinoif_dac.vhd, dinoif_fast_nologic.vhd]
2024-06-18 hdl: make config timer accept new timer value synchronous to separate clock
