RWTH-ACS/dino/(notices)

Notices in the files:
parts and their libraries:
TDN3-1221WISM: COPYRIGHT: Copyright (C) 2018 Accelerated Designs. All rights reserved
LT6654AIS6-2.048: COPYRIGHT: Copyright (C) 2016 Accelerated Designs. All rights reserved
COPYRIGHT: Copyright (C) 2021 Ultra Librarian. All rights reserved.
